crawford/PoE/README.md

# Power over Ethernet #

## Development ###

This project makes use of git commit hooks. Configure git to use them by running the following from the root of the repository:

    git config --local core.hooksPath .githooks/
