crawford/PoE/hardware/passthru/passthru.kicad_pcb

## KiCad design hardware/passthru/passthru.kicad_pcb (2023-05-25)

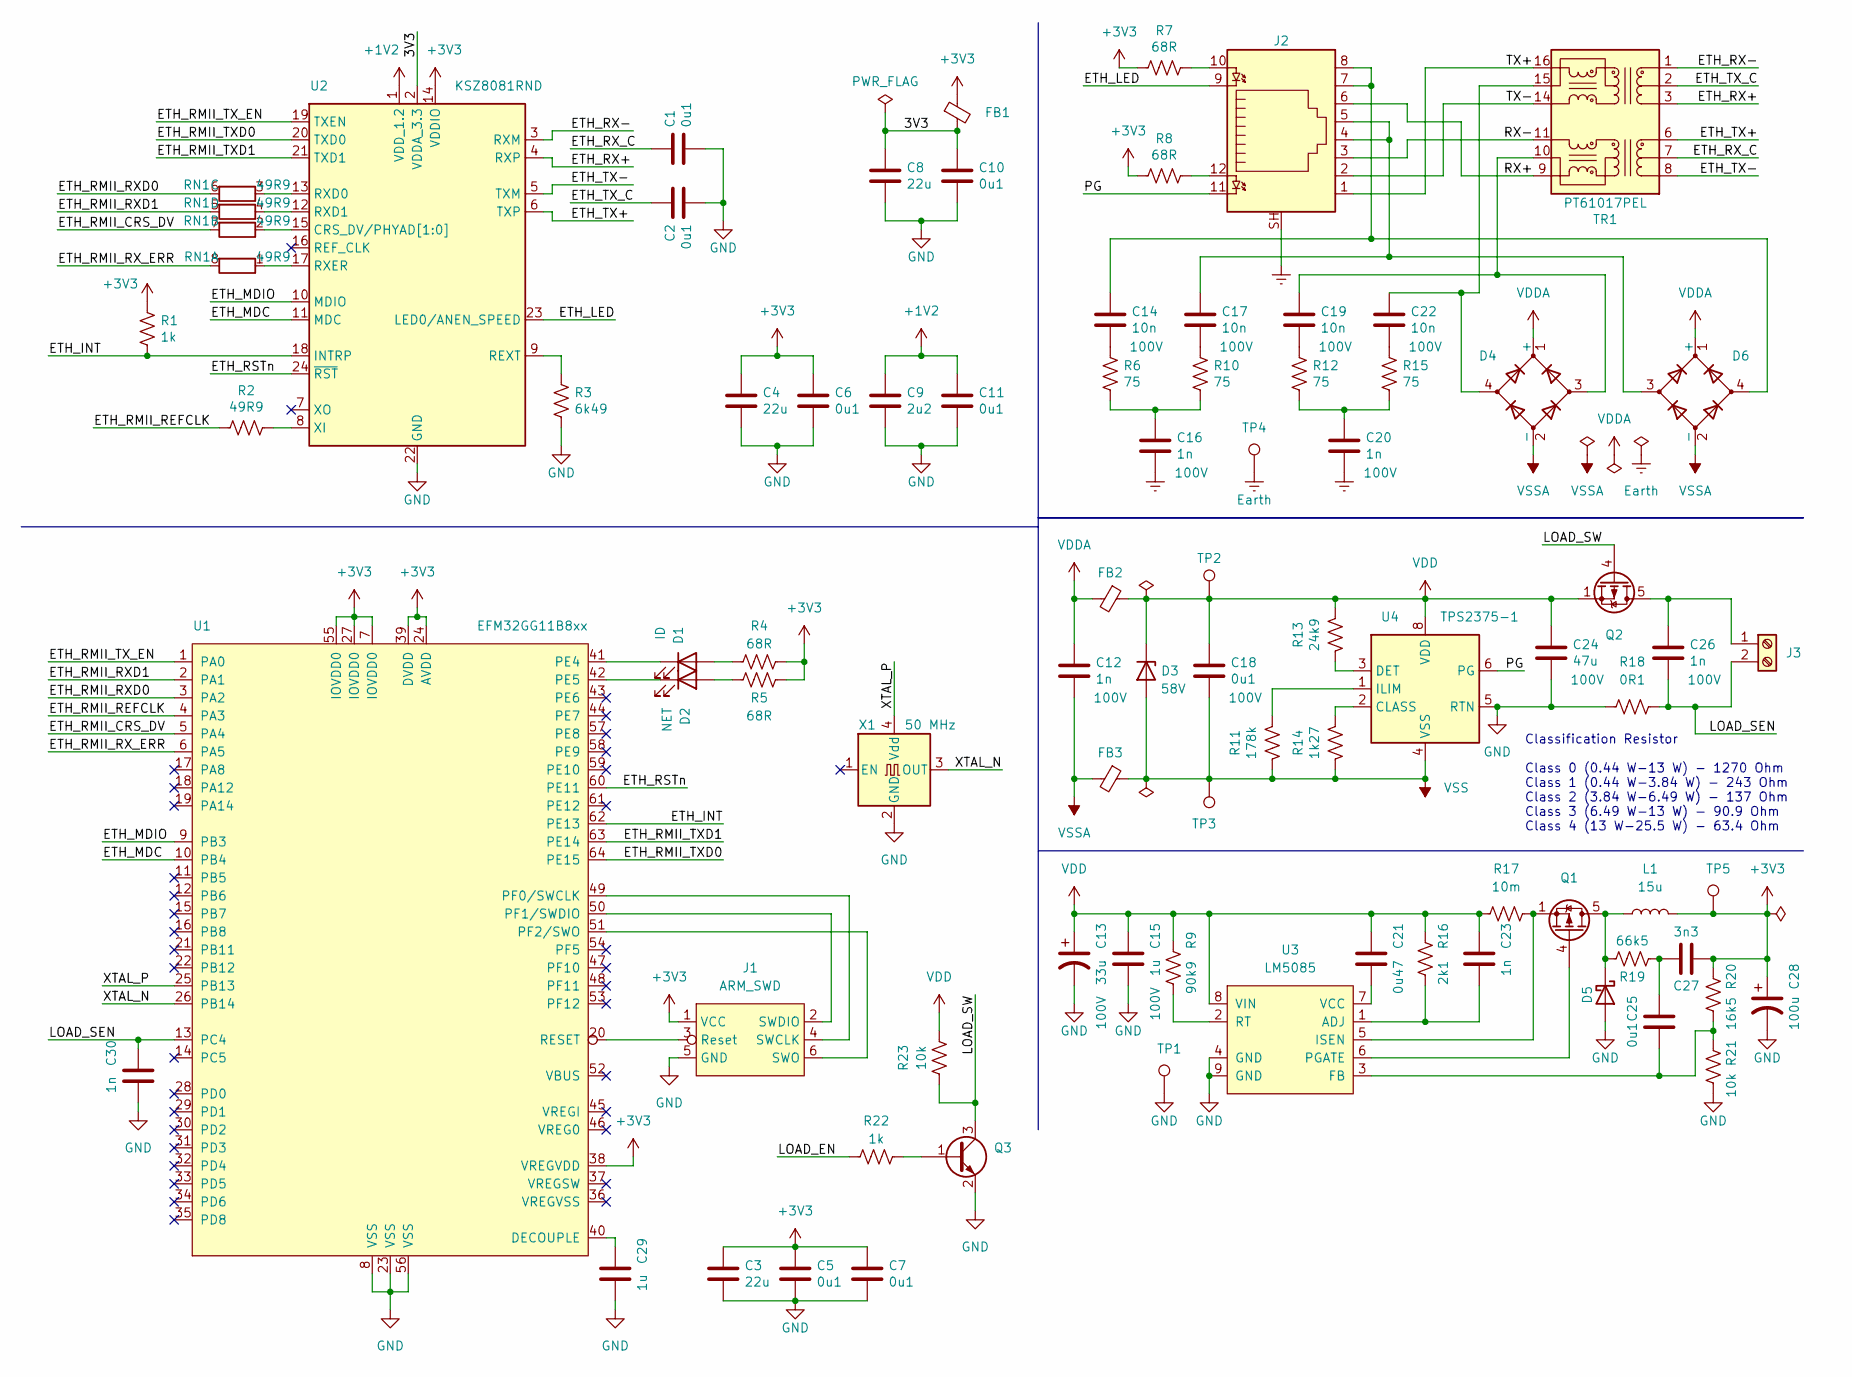
[picture p1: schematic passthru.kicad_sch, Gated Passthrough]

Parts:
C1, C2, C5, C6, C7, C10, C11, C25: 0u1; C_0603_1608Metric_Pad1.08x0.95mm_HandSolder
C3, C4, C8: 22u; C_0603_1608Metric_Pad1.08x0.95mm_HandSolder
C9: 2u2; C_0603_1608Metric_Pad1.08x0.95mm_HandSolder
C12, C16, C20, C26: 1n; C_0603_1608Metric_Pad1.08x0.95mm_HandSolder; Voltage 100V
C13: 33u; CP_Elec_10x10; Voltage 100V
C14, C17, C19, C22: 10n; C_0603_1608Metric_Pad1.08x0.95mm_HandSolder; Voltage 100V
C15: 1u; C_0603_1608Metric_Pad1.08x0.95mm_HandSolder; Voltage 100V
C18: 0u1; C_0603_1608Metric_Pad1.08x0.95mm_HandSolder; Voltage 100V
C21: 0u47; C_0603_1608Metric_Pad1.08x0.95mm_HandSolder
C23, C30: 1n; C_0603_1608Metric_Pad1.08x0.95mm_HandSolder
C24: 47u; CP_Elec_10x12.5; Voltage 100V
C27: 3n3; C_0603_1608Metric_Pad1.08x0.95mm_HandSolder
C28: 100u; CP_Elec_6.3x5.8
C29: 1u; C_0603_1608Metric_Pad1.08x0.95mm_HandSolder
D1: ID; LED_D4.0mm
D2: NET; LED_D4.0mm
D3: D_Zener; D_SMA; Voltage 58V
D4, D6: D_Bridge_+-AA; Diode_Bridge_Diotec_ABS
D5: D_Schottky; D_SOD-323F
FB1, FB2, FB3: Ferrite_Bead_Small; L_0603_1608Metric_Pad1.05x0.95mm_HandSolder
J1: ARM_SWD; Tag-Connect_TC2030-IDC-NL_2x03_P1.27mm_Vertical
J2: RJ45_LED_Shielded; RJHSE-338X
J3: Screw_Terminal_01x02; Phoenix_1935161
L1: 15u; L_1210_3225Metric_Pad1.42x2.65mm_HandSolder
Q1, Q2: Q_PMOS_DGS; PowerPAK_SO-8_Single
Q3: Q_NPN_BEC; SOT-23
R1, R22: 1k; R_0603_1608Metric_Pad0.98x0.95mm_HandSolder
R2: 49R9; R_0603_1608Metric_Pad0.98x0.95mm_HandSolder
R3: 6k49; R_0603_1608Metric_Pad0.98x0.95mm_HandSolder
R4, R5, R7, R8: 68R; R_0603_1608Metric_Pad0.98x0.95mm_HandSolder
R6, R10, R12, R15: 75; R_0603_1608Metric_Pad0.98x0.95mm_HandSolder
R9: 90k9; R_0603_1608Metric_Pad0.98x0.95mm_HandSolder
R11: 178k; R_0603_1608Metric_Pad0.98x0.95mm_HandSolder
R13: 24k9; R_0603_1608Metric_Pad0.98x0.95mm_HandSolder
R14: 1k27; R_0603_1608Metric_Pad0.98x0.95mm_HandSolder
R16: 2k1; R_0603_1608Metric_Pad0.98x0.95mm_HandSolder
R17: 10m; R_0603_1608Metric_Pad0.98x0.95mm_HandSolder
R18: 0R1; R_0805_2012Metric_Pad1.20x1.40mm_HandSolder
R19: 66k5; R_0603_1608Metric_Pad0.98x0.95mm_HandSolder
R20: 16k5; R_0603_1608Metric_Pad0.98x0.95mm_HandSolder
R21, R23: 10k; R_0603_1608Metric_Pad0.98x0.95mm_HandSolder
RN1: 49R9; R_Cat16-4
TP1: GND; TestPoint_Loop_D1.80mm_Drill1.0mm_Beaded
TP2: VDD; TestPoint_Loop_D1.80mm_Drill1.0mm_Beaded
TP3: VSS; TestPoint_Loop_D1.80mm_Drill1.0mm_Beaded
TP4: EARTH; TestPoint_Loop_D1.80mm_Drill1.0mm_Beaded
TP5: 3V3; TestPoint_Loop_D1.80mm_Drill1.0mm_Beaded
TR1: PT61017PEL
U1: EFM32GG11B8xx; QFP-64
U2: KSZ8081RND; QFN-24
U3: LM5085; WSON-8-1EP_3x3mm_P0.5mm_EP1.6x2.0mm
U4: TPS2375-1; TSSOP-8_4.4x3mm_P0.65mm
X1: 50 MHz; Oscillator_SMD_Abracon_ASE-4Pin_3.2x2.5mm

Connections:
+1V2: C9.1, C11.1, U2.1 (VDD_1.2)
+3V3: C3.1, C4.1, C5.1, C6.1, C7.1, C27.1, C28.1, FB1.1, J1.1 (VCC), L1.2, R1.1, R4.2, R5.2, R7.2, R8.2, R20.1, TP5.1, U1.7 (IOVDD0), U1.24 (AVDD), U1.27 (IOVDD0), U1.38 (VREGVDD), U1.39 (DVDD), U1.55 (IOVDD0), U2.14 (VDDIO)
/3V3: C8.1, C10.1, FB1.2, U2.2 (VDDA_3.3)
/ETH_INT: R1.2, U1.62 (PE13), U2.18 (INTRP)
/ETH_LED: J2.9, U2.23 (LED0/ANEN_SPEED)
/ETH_MDC: U1.10 (PB4), U2.11 (MDC)
/ETH_MDIO: U1.9 (PB3), U2.10 (MDIO)
/ETH_RMII_CRS_DV: RN1.7 (R2.2), U1.5 (PA4)
/ETH_RMII_REFCLK: R2.2, U1.4 (PA3)
/ETH_RMII_RXD0: RN1.6 (R3.2), U1.3 (PA2)
/ETH_RMII_RXD1: RN1.5 (R4.2), U1.2 (PA1)
/ETH_RMII_RX_ERR: RN1.8 (R1.2), U1.6 (PA5)
/ETH_RMII_TXD0: U1.64 (PE15), U2.20 (TXD0)
/ETH_RMII_TXD1: U1.63 (PE14), U2.21 (TXD1)
/ETH_RMII_TX_EN: U1.1 (PA0), U2.19 (TXEN)
/ETH_RSTn: U1.60 (PE11), U2.24 (~RST)
/ETH_RX+: TR1.3 (TD-), U2.4 (RXP)
/ETH_RX-: TR1.1 (TD+), U2.3 (RXM)
/ETH_RX_C: C1.1, TR1.7 (C_RD)
/ETH_TX+: TR1.6 (RD+), U2.6 (TXP)
/ETH_TX-: TR1.8 (RD-), U2.5 (TXM)
/ETH_TX_C: C2.1, TR1.2 (C_TD)
/LOAD_EN: R22.1
/LOAD_SEN: C26.2, C30.1, J3.2, R18.2, U1.13 (PC4)
/LOAD_SW: Q2.4 (G), Q3.3 (C), R23.1
/PG: J2.11, U4.6 (PG)
/RX+: J2.6, TR1.9 (RX-)
/RX-: J2.3, TR1.11 (RX+)
/TX+: J2.1, TR1.16 (TX+)
/TX-: J2.2, TR1.14 (TX-)
/XTAL_N: U1.26 (PB14), X1.3 (OUT)
/XTAL_P: U1.25 (PB13), X1.4 (Vdd)
Earth: C16.2, C20.2, J2.SH, TP4.1
GND: C1.2, C2.2, C3.2, C4.2, C5.2, C6.2, C7.2, C8.2, C9.2, C10.2, C11.2, C13.2, C15.2, C24.2, C28.2, C29.2, C30.2, D5.2 (A), J1.5 (GND), Q3.2 (E), R3.2, R18.1, R21.2, TP1.1, U1.8 (VSS), U1.23 (VSS), U1.56 (VSS), U2.22 (GND), U2.25 (GND), U3.4 (GND), U3.9 (GND), U4.5 (RTN), X1.2 (GND)
unnamed: C14.1, D6.4, J2.7, J2.8
unnamed: C14.2, R6.1
unnamed: C16.1, R6.2, R10.2
unnamed: C17.1, D6.3, J2.4, J2.5
unnamed: C17.2, R10.1
unnamed: C19.1, D4.3, TR1.10 (C_RX)
unnamed: C19.2, R12.1
unnamed: C20.1, R12.2, R15.2
unnamed: C21.2, U3.7 (VCC)
unnamed: C22.1, D4.4, TR1.15 (C_TX)
unnamed: C22.2, R15.1
unnamed: C23.1, R16.1, U3.1 (ADJ)
unnamed: C25.1, R20.2, R21.1, U3.3 (FB)
unnamed: C25.2, C27.2, R19.1
unnamed: C26.1, J3.1, Q2.5 (D)
unnamed: C29.1, U1.40 (DECOUPLE)
unnamed: D1.1 (K), U1.41 (PE4)
unnamed: D1.2 (A), R4.1
unnamed: D2.1 (K), U1.42 (PE5)
unnamed: D2.2 (A), R5.1
unnamed: D5.1 (K), L1.1, Q1.5 (D), R19.2
unnamed: J1.2 (SWDIO), U1.50 (PF1/SWDIO)
unnamed: J1.3 (Reset), U1.20 (RESET)
unnamed: J1.4 (SWCLK), U1.49 (PF0/SWCLK)
unnamed: J1.6 (SWO), U1.51 (PF2/SWO)
unnamed: J2.10, R7.1
unnamed: J2.12, R8.1
unnamed: Q1.1 (S), Q1.2 (S), Q1.3 (S), R17.2, U3.5 (ISEN)
unnamed: Q1.4 (G), U3.6 (PGATE)
unnamed: Q3.1 (B), R22.2
unnamed: R2.1, U2.8 (XI)
unnamed: R3.1, U2.9 (REXT)
unnamed: R9.1, U3.2 (RT)
unnamed: R11.2, U4.1 (ILIM)
unnamed: R13.1, U4.3 (DET)
unnamed: R14.2, U4.2 (CLASS)
unnamed: RN1.1 (R1.1), U2.17 (RXER)
unnamed: RN1.2 (R2.1), U2.15 (CRS_DV/PHYAD[1:0])
unnamed: RN1.3 (R3.1), U2.13 (RXD0)
unnamed: RN1.4 (R4.1), U2.12 (RXD1)
VDD: C13.1, C15.1, C18.1, C21.1, C23.2, C24.1, D3.1 (K), FB2.1, Q2.1 (S), Q2.2 (S), Q2.3 (S), R9.2, R13.2, R16.2, R17.1, R23.2, TP2.1, U3.8 (VIN), U4.8 (VDD)
VDDA: C12.1, D4.1 (+), D6.1 (+), FB2.2
VSS: C18.2, D3.2 (A), FB3.1, R11.1, R14.1, TP3.1, U4.4 (VSS)
VSSA: C12.2, D4.2 (-), D6.2 (-), FB3.2

Notes on the sheet:
Classification Resistor Class 0 (0.44 W-13 W) - 1270 Ohm Class 1 (0.44 W-3.84 W) - 243 Ohm Class 2 (3.84 W-6.49 W) - 137 Ohm Class 3 (6.49 W-13 W) - 90.9 Ohm Class 4 (13 W-25.5 W) - 63.4 Ohm

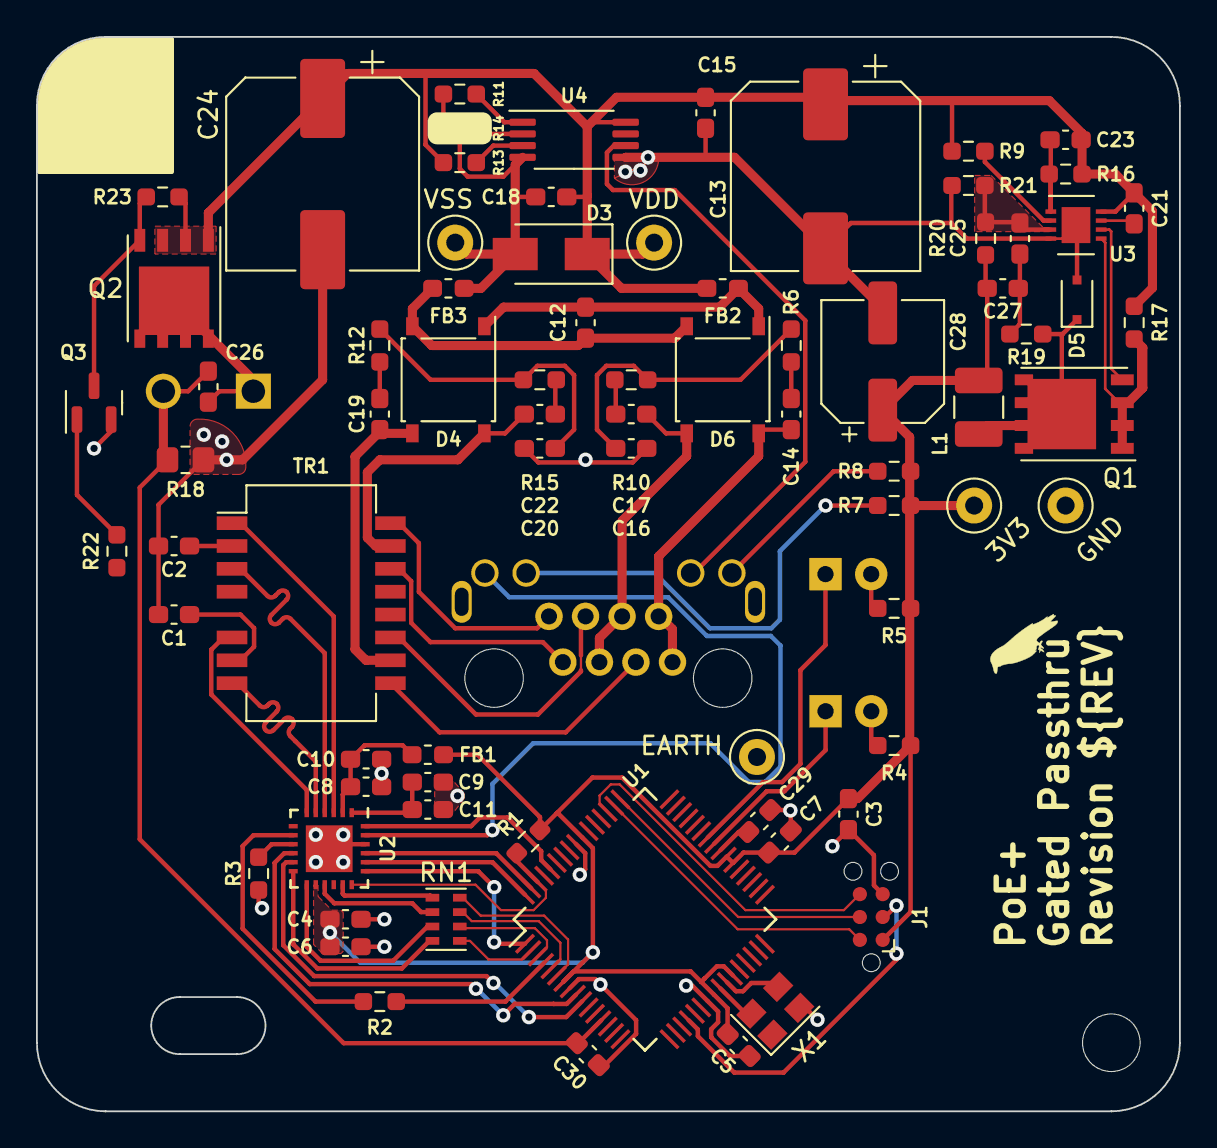
[picture p2: board passthru.kicad_pcb from above]

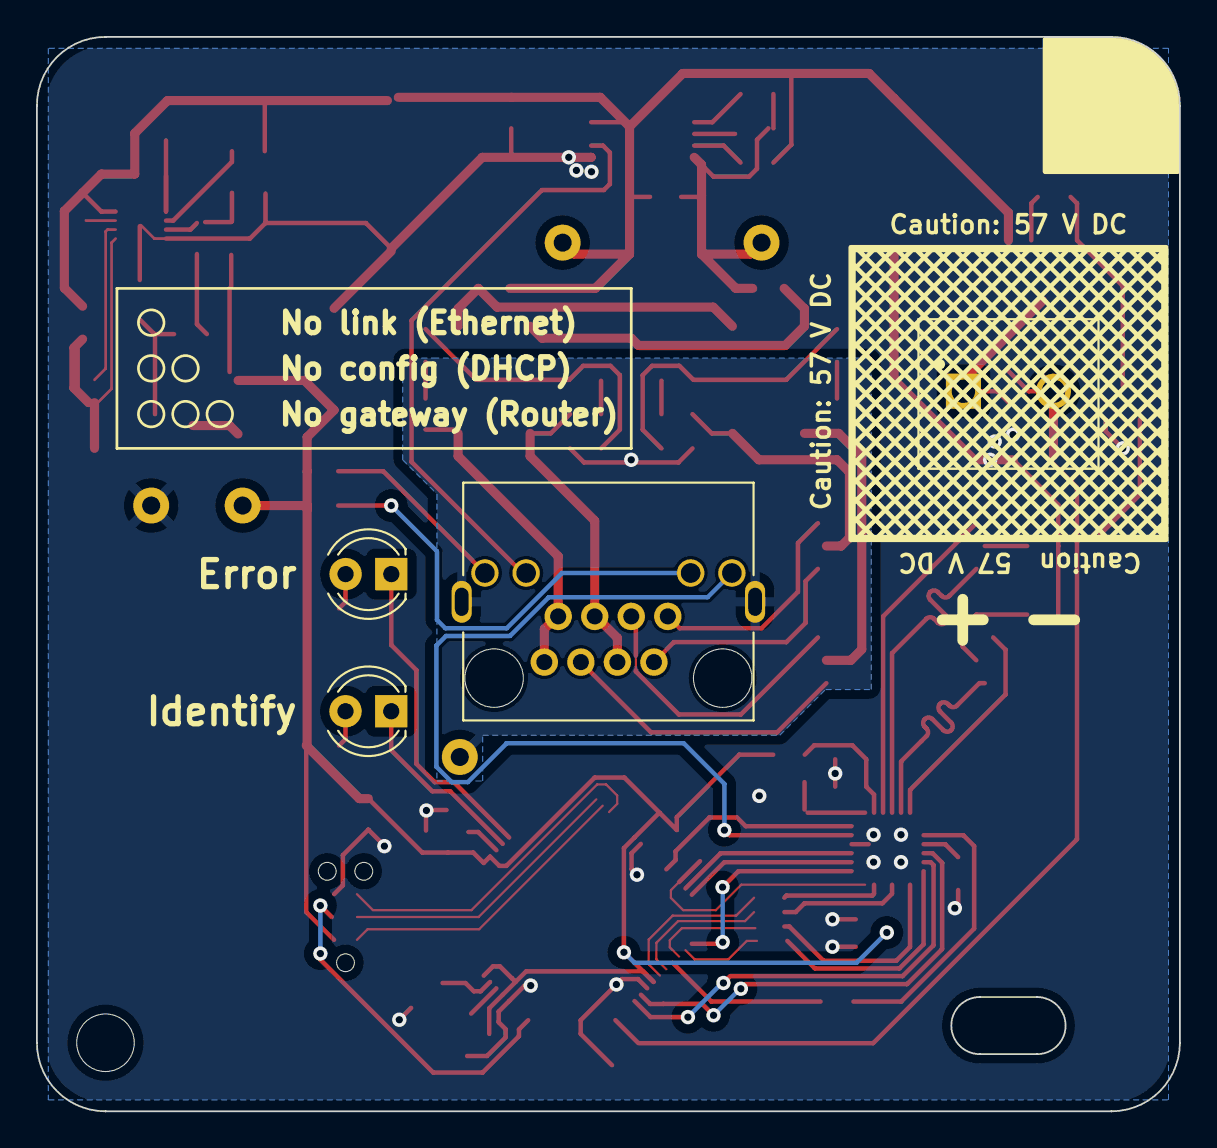
[picture p3: board passthru.kicad_pcb from below]

Board: 2 copper layers, 63.5 x 59.7 mm, 81 parts (4 on the bottom side), 77 nets.
