crawford/PoE/hardware/sync-flyback-eval/sync-flyback-eval.kicad_pcb

## KiCad design hardware/sync-flyback-eval/sync-flyback-eval.kicad_pcb (2022-09-16)

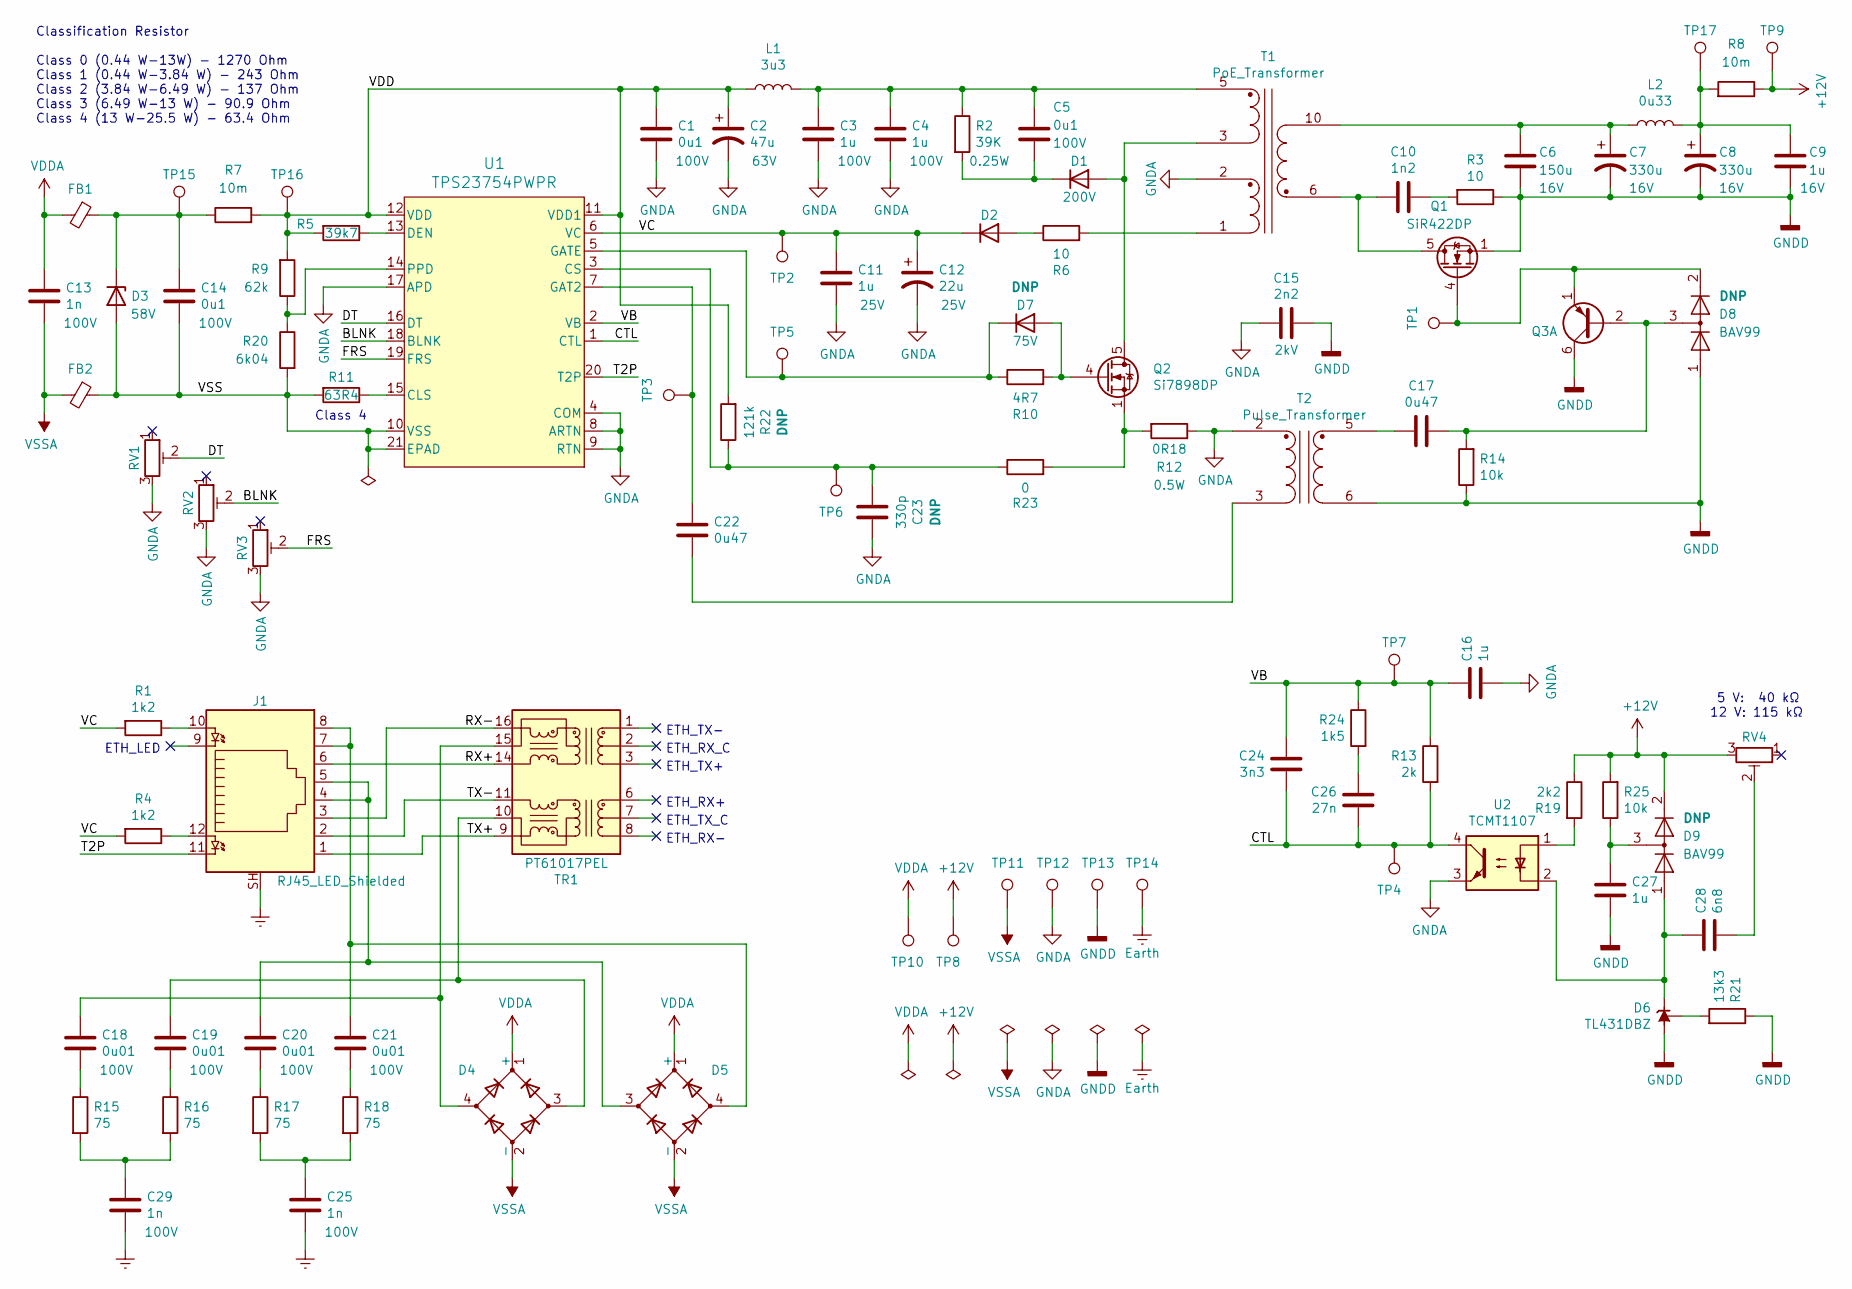
[picture p4: schematic sync-flyback-eval.kicad_sch, Synchronous Flyback Converter - Evaluation Board]

Parts:
C1, C5, C14: 0u1; C_0402_1005Metric; Voltage 100V
C2: 47u; C_Elec_8x10.2; Voltage 63V
C3, C4: 1u; C_0805_2012Metric; Voltage 100V
C6: 150u; C_Elec_6.3x7.7; Voltage 16V
C7, C8: 330u; C_Elec_8x10.2; Voltage 16V
C9: 1u; C_0402_1005Metric; Voltage 16V
C10: 1n2; C_0402_1005Metric
C11: 1u; C_0402_1005Metric; Voltage 25V
C12: 22u; C_Elec_5x5.4; Voltage 25V
C13, C25, C29: 1n; C_0402_1005Metric; Voltage 100V
C15: 2n2; C_Disc_D10.0mm_W2.5mm_P5.00mm; Voltage 2kV
C16, C27: 1u; C_0402_1005Metric
C17, C22: 0u47; C_0402_1005Metric
C18, C19, C20, C21: 0u01; C_0402_1005Metric; Voltage 100V
C23: 330p; C_0402_1005Metric
C24: 3n3; C_0402_1005Metric
C26: 27n; C_0402_1005Metric
C28: 6n8; C_0402_1005Metric
D1: D; D_SMB; Voltage 200V
D2: D; D_SOD-323
D3: D_Zener; D_SMA; Voltage 58V
D4, D5: D_Bridge_+-AA; Diode_Bridge_Diotec_ABS
D6: TL431DBZ; SOT-23
D7: D; D_SOD-323; Voltage 75V
D8, D9: BAV99; SOT-23
FB1, FB2: Ferrite_Bead_Small; R_1206_3216Metric
J1: RJ45_LED_Shielded; RJHSE-538X
L1: 3u3; L_Abracon_ASPI-0630LR
L2: 0u33; L_Abracon_ASPI-0630LR
Q1: SiR422DP; PowerPAK_SO-8_Single
Q2: Si7898DP; PowerPAK_SO-8_Single
Q3: MMDT3906; SOT-363_SC-70-6
R1, R4: 1k2; R_0402_1005Metric
R2: 39K; R_0805_2012Metric
R3, R6: 10; R_0805_2012Metric
R5: 39k7; R_0402_1005Metric
R7, R8: 10m; R_0402_1005Metric
R9: 62k; R_0402_1005Metric
R10: 4R7; R_0402_1005Metric
R11: 63R4; R_0402_1005Metric
R12: 0R18; R_0805_2012Metric
R13: 2k; R_0402_1005Metric
R14, R25: 10k; R_0402_1005Metric
R15, R16, R17, R18: 75; R_0402_1005Metric
R19: 2k2; R_0402_1005Metric
R20: 6k04; R_0402_1005Metric
R21: 13k3; R_0402_1005Metric
R22: 121k; R_0402_1005Metric
R23: 0; R_0402_1005Metric
R24: 1k5; R_0402_1005Metric
RV1, RV2, RV3, RV4: 0-200k; TRIM_3306F-1-204
T1: PoE_Transformer; WE-PoE+
T2: Pulse_Transformer; WE-GDTI
TP1: TestPoint; TestPoint_Pad_1.5x1.5mm
TP2: VC; TestPoint_Loop_D1.80mm_Drill1.0mm_Beaded
TP3: GAT2; TestPoint_Pad_1.5x1.5mm
TP4: CTL; TestPoint_Pad_1.5x1.5mm
TP5: GAT; TestPoint_Pad_1.5x1.5mm
TP6: CS; TestPoint_Pad_1.5x1.5mm
TP7, TP9, TP15, TP16, TP17: VB; TestPoint_Loop_D1.80mm_Drill1.0mm_Beaded
TP8: 12V; TestPoint_Loop_D1.80mm_Drill1.0mm_Beaded
TP10: VDDA1; TestPoint_Loop_D1.80mm_Drill1.0mm_Beaded
TP11: VSSA1; TestPoint_Loop_D1.80mm_Drill1.0mm_Beaded
TP12, TP13: GND; TestPoint_Loop_D1.80mm_Drill1.0mm_Beaded
TP14: EARTH; TestPoint_Loop_D1.80mm_Drill1.0mm_Beaded
TR1: PT61017PEL
U1: TPS23754PWPR; TSSOP-20
U2: TCMT1107; SOP-4_4.4x2.6mm_P1.27mm

Connections:
+12V: D9.2 (A), R8.1, R19.1, R25.2, RV4.3, TP8.1, TP9.1
/BLNK: RV2.2, U1.18 (BLNK)
/CTL: C24.2, C26.2, R13.2, TP4.1, U1.1 (CTL), U2.4
/DT: RV1.2, U1.16 (DT)
/FRS: RV3.2, U1.19 (FRS)
/RX+: J1.6, TR1.14 (TX-)
/RX-: J1.3, TR1.16 (TX+)
/T2P: J1.11, U1.20 (T2P)
/TX+: J1.1, TR1.9 (RX-)
/TX-: J1.2, TR1.11 (RX+)
/VB: C16.1, C24.1, R13.1, R24.1, TP7.1, U1.2 (VB)
/VC: C11.1, C12.1, D2.1 (K), R1.2, R4.2, TP2.1, U1.6 (VC)
/VDD: C1.1, C2.1, L1.1, R5.2, R7.2, R9.2, R22.2, TP16.1, U1.11 (VDD1), U1.12 (VDD)
/VSS: C14.2, D3.2 (A), FB2.1, R11.2, R20.2, U1.10 (VSS), U1.21 (EPAD)
Earth: C25.2, C29.2, J1.SH, TP14.1
GNDA: C1.2, C2.2, C3.2, C4.2, C11.2, C12.2, C15.2, C16.2, C23.1, R12.1, RV1.3, RV2.3, RV3.3, T1.2 (SC), T2.2 (AA), TP12.1, U1.4 (COM), U1.8 (ARTN), U1.9 (RTN), U1.17 (APD), U2.3
GNDD: C6.2, C7.2, C8.2, C9.2, C15.1, C27.2, D6.3 (A), D8.1 (K), Q1.1 (S), Q1.2 (S), Q1.3 (S), Q3.6 (C1), R3.1, R14.1, R21.1, T2.6 (SA), TP13.1
unnamed: C3.1, C4.1, C5.1, L1.2, R2.1, T1.5 (SA)
unnamed: C5.2, D1.1 (K), R2.2
unnamed: C6.1, C7.1, L2.1, T1.10 (AA)
unnamed: C8.1, C9.1, L2.2, R8.2, TP17.1
unnamed: C10.1, R3.2
unnamed: C10.2, Q1.5 (D), T1.6 (AB)
unnamed: C14.1, D3.1 (K), FB1.1, R7.1, TP15.1
unnamed: C17.1, D8.3 (K), Q3.2 (B1), R14.2
unnamed: C17.2, T2.5 (SB)
unnamed: C18.1, D4.4, TR1.15 (C_TX)
unnamed: C18.2, R15.1
unnamed: C19.1, D4.3, TR1.10 (C_RX)
unnamed: C19.2, R16.1
unnamed: C20.1, D5.3, J1.4, J1.5
unnamed: C20.2, R17.1
unnamed: C21.1, D5.4, J1.7, J1.8
unnamed: C21.2, R18.1
unnamed: C22.1, T2.3 (AB)
unnamed: C22.2, TP3.1, U1.7 (GAT2)
unnamed: C23.2, R22.1, R23.1, TP6.1, U1.3 (CS)
unnamed: C25.1, R17.2, R18.2
unnamed: C26.1, R24.2
unnamed: C27.1, D9.3 (K), R25.1
unnamed: C28.1, D6.1 (K), D9.1 (K), U2.2
unnamed: C28.2, RV4.2
unnamed: C29.1, R15.2, R16.2
unnamed: D1.2 (A), Q2.5 (D), T1.3 (SB)
unnamed: D2.2 (A), R6.1
unnamed: D6.2 (REF), R21.2
unnamed: D7.1 (K), R10.1, TP5.1, U1.5 (GATE)
unnamed: D7.2 (A), Q2.4 (G), R10.2
unnamed: D8.2 (A), Q1.4 (G), Q3.1 (E1), TP1.1
unnamed: J1.10, R1.1
unnamed: J1.12, R4.1
unnamed: Q2.1 (S), Q2.2 (S), Q2.3 (S), R12.2, R23.2
unnamed: R5.1, U1.13 (DEN)
unnamed: R6.2, T1.1 (SD)
unnamed: R11.1, U1.15 (CLS)
unnamed: R19.2, U2.1
unnamed: R9.1, R20.1, U1.14 (PPD)
VDDA: C13.1, D4.1 (+), D5.1 (+), FB1.2, TP10.1
VSSA: C13.2, D4.2 (-), D5.2 (-), FB2.2, TP11.1

Notes on the sheet:
5 V: 40 kΩ 12 V: 115 kΩ
ETH_RX_C
ETH_LED
ETH_TX-
ETH_TX+
Classification Resistor Class 0 (0.44 W-13W) - 1270 Ohm Class 1 (0.44 W-3.84 W) - 243 Ohm Class 2 (3.84 W-6.49 W) - 137 Ohm Class 3 (6.49 W-13 W) - 90.9 Ohm Class 4 (13 W-25.5 W) - 63.4 Ohm
ETH_RX-
ETH_RX+
ETH_TX_C
Class 4

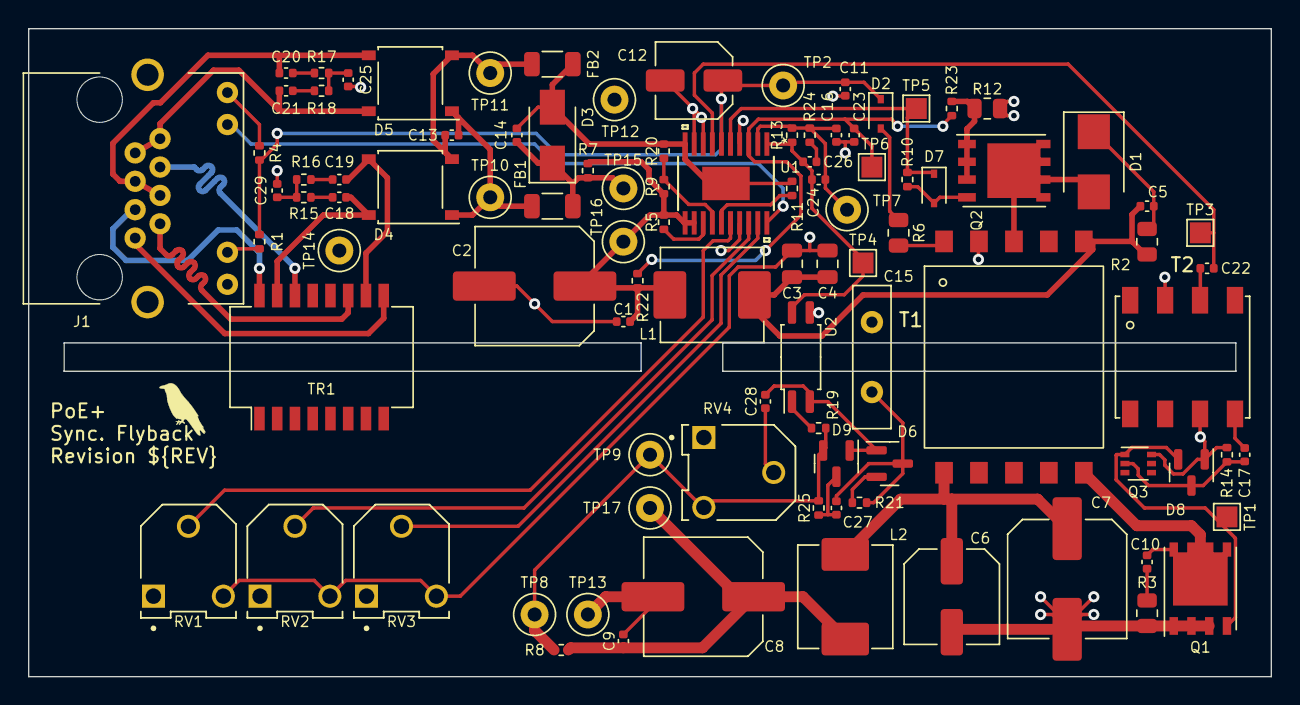
[picture p5: board sync-flyback-eval.kicad_pcb from above]

Board: 2 copper layers, 88.9 x 46.4 mm, 97 parts (0 on the bottom side), 59 nets.
