crawford/PoE/hardware/chassis/chassis.kicad_pcb

## KiCad design hardware/chassis/chassis.kicad_pcb (2022-07-24)

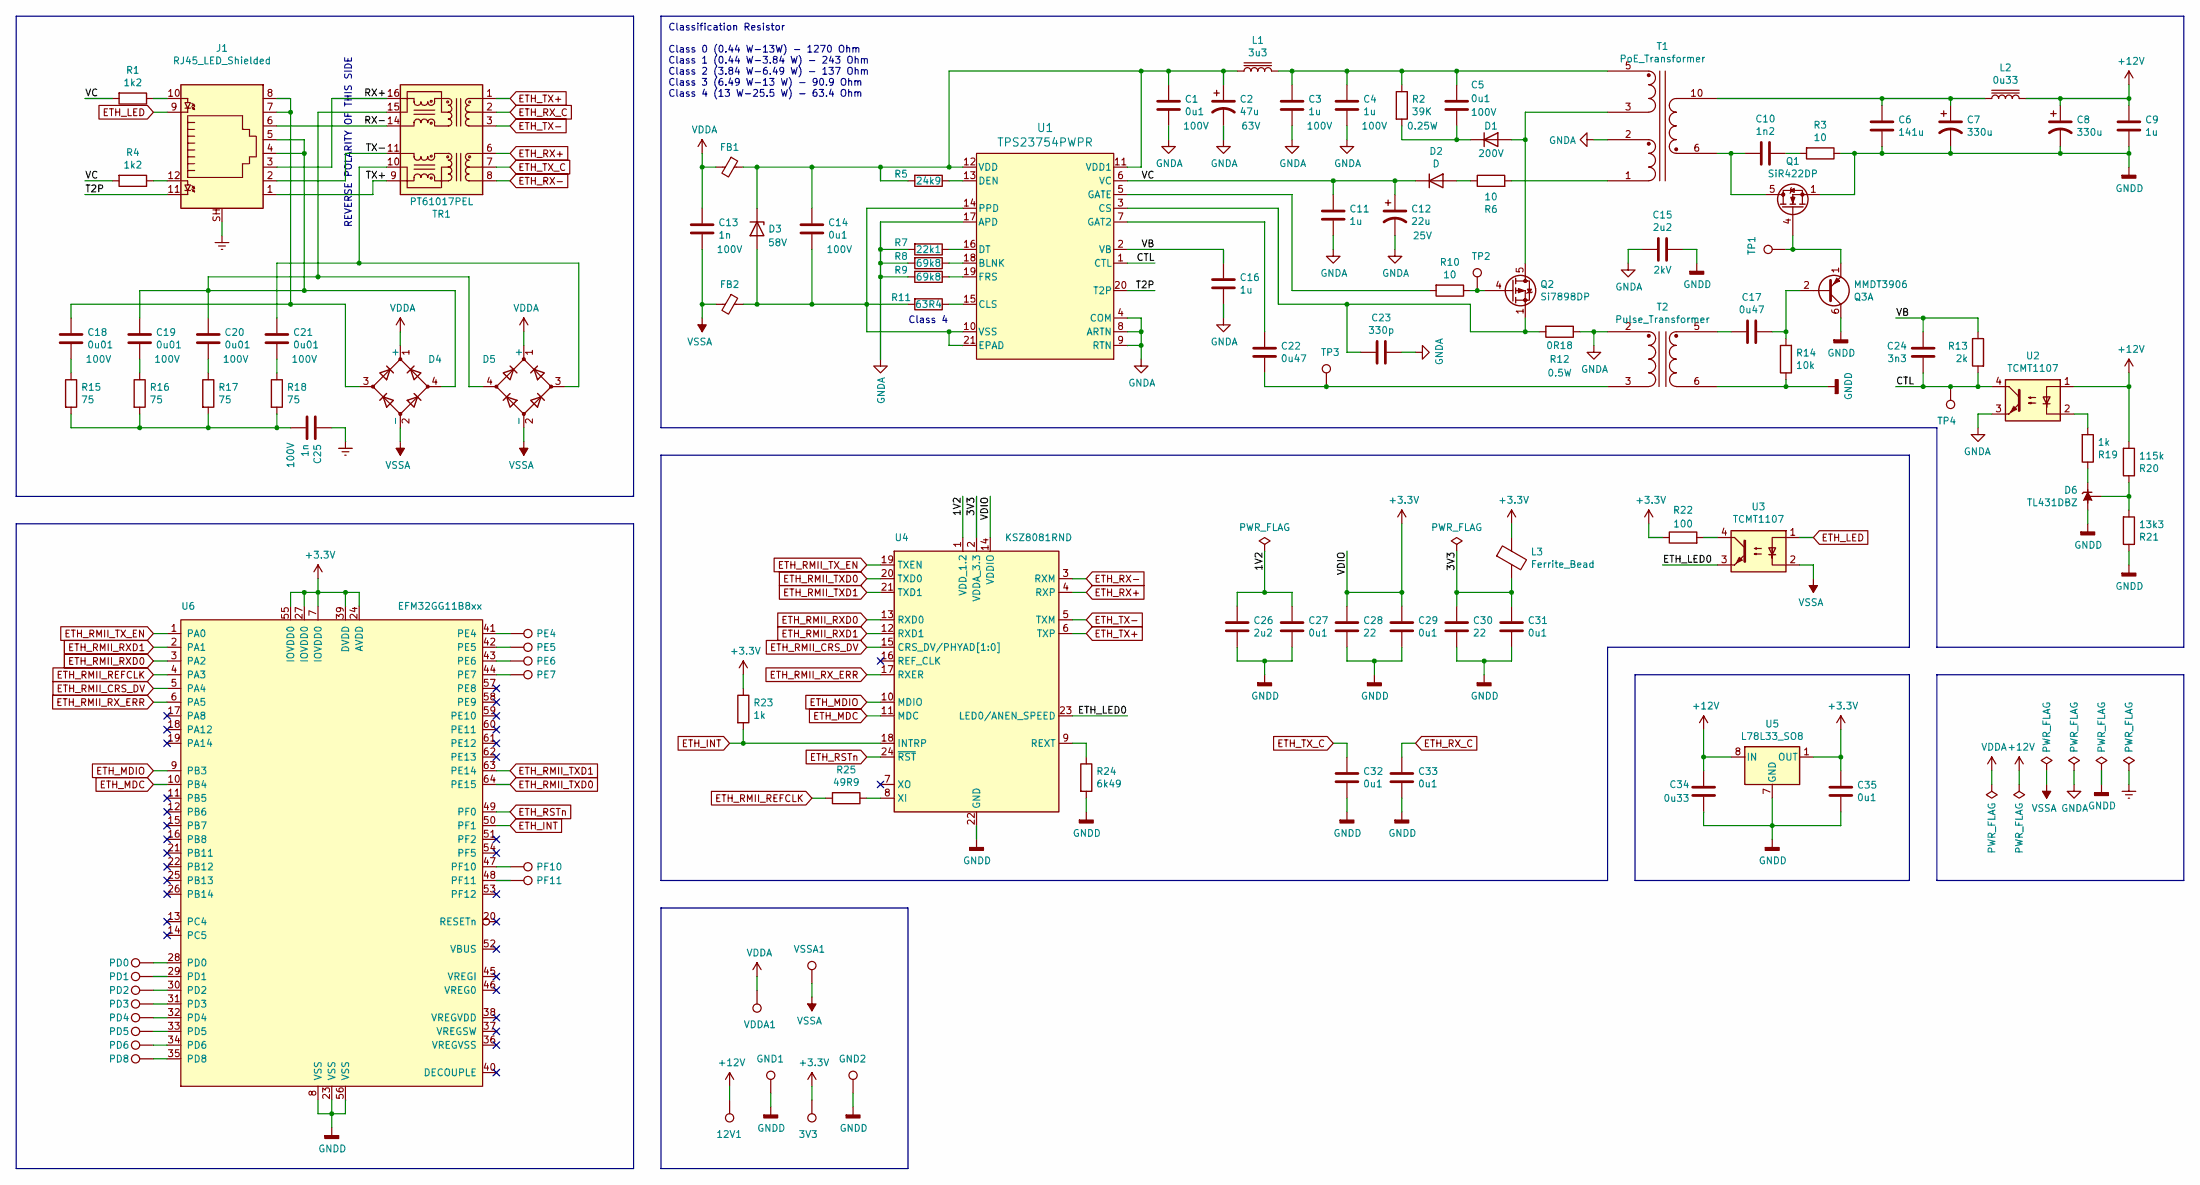
[picture p6: schematic chassis.kicad_sch, Power Over Ethernet Chassis]

Parts:
3V3: TestPoint; TestPoint_Pad_1.5x1.5mm
12V1: TestPoint; TestPoint_Loop_D1.80mm_Drill1.0mm_Beaded
C1, C5, C14: 0u1; C_0402_1005Metric; Voltage 100V
C2: 47u; C_0402_1005Metric; Voltage 63V
C3, C4: 1u; C_0402_1005Metric; Voltage 100V
C6: 141u; C_0402_1005Metric
C7, C8: 330u; C_0402_1005Metric
C9, C11, C16: 1u; C_0402_1005Metric
C10: 1n2; C_0402_1005Metric
C12: 22u; C_0402_1005Metric; Voltage 25V
C13, C25: 1n; C_0402_1005Metric; Voltage 100V
C15: 2u2; C_0402_1005Metric; Voltage 2kV
C17, C22: 0u47; C_0402_1005Metric
C18, C19, C20, C21: 0u01; C_0402_1005Metric; Voltage 100V
C23: 330p; C_0402_1005Metric
C24: 3n3; C_0402_1005Metric
C26: 2u2; C_0402_1005Metric
C27, C29, C31, C32, C33, C35: 0u1; C_0402_1005Metric
C28, C30: 22; C_0402_1005Metric
C34: 0u33; C_0402_1005Metric
D1: D; D_0402_1005Metric; Voltage 200V
D2: D; D_0402_1005Metric
D3: D_Zener; D_0402_1005Metric; Voltage 58V
D4, D5: D_Bridge_+-AA; Diode_Bridge_Diotec_ABS
D6: TL431DBZ; SOT-23
FB1, FB2: Ferrite_Bead_Small; R_1206_3216Metric
GND1: TestPoint; TestPoint_Loop_D1.80mm_Drill1.0mm_Beaded
GND2: TestPoint; TestPoint_Pad_1.5x1.5mm
J1: RJ45_LED_Shielded; RJHSE-538X
L1: 3u3; L_0402_1005Metric
L2: 0u33; L_0402_1005Metric
L3: Ferrite_Bead; L_0402_1005Metric
PD0, PD1, PD2, PD3, PD4, PD5, PD6, PD8: TestPoint; TestPoint_Pad_1.5x1.5mm
PE4, PE5, PE6, PE7: TestPoint; TestPoint_Pad_1.5x1.5mm
PF10, PF11: TestPoint; TestPoint_Pad_1.5x1.5mm
Q1: SiR422DP; PowerPAK_SO-8_Single
Q2: Si7898DP; PowerPAK_SO-8_Single
Q3: MMDT3906; SOT-363_SC-70-6
R1, R4: 1k2; R_0402_1005Metric
R2: 39K; R_0402_1005Metric
R3, R6, R10: 10; R_0402_1005Metric
R5: 24k9; R_0402_1005Metric
R7: 22k1; R_0402_1005Metric
R8, R9: 69k8; R_0402_1005Metric
R11: 63R4; R_0402_1005Metric
R12: 0R18; R_0402_1005Metric
R13: 2k; R_0402_1005Metric
R14: 10k; R_0402_1005Metric
R15, R16, R17, R18: 75; R_0402_1005Metric
R19, R23: 1k; R_0402_1005Metric
R20: 115k; R_0402_1005Metric
R21: 13k3; R_0402_1005Metric
R22: 100; R_0402_1005Metric
R24: 6k49; R_0402_1005Metric
R25: 49R9; R_0402_1005Metric
T1: PoE_Transformer; POE_EP13
T2: Pulse_Transformer; GDTI_EP7
TP1, TP2, TP3, TP4: TestPoint; TestPoint_Pad_1.5x1.5mm
TR1: PT61017PEL; Transformer_Ethernet_Bourns_PT61017PEL
U1: TPS23754PWPR; TSSOP-20
U2, U3: TCMT1107; SOP-4_4.4x2.6mm_P1.27mm
U4: KSZ8081RND; QFN-24
U5: L78L33_SO8; SOIC-8_3.9x4.9mm_P1.27mm
U6: EFM32GG11B8xx; QFP-64
VDDA1: TestPoint; TestPoint_Pad_1.5x1.5mm
VSSA1: TestPoint; TestPoint_Pad_1.5x1.5mm

Connections:
+3V3: 3V3.1, C28.1, C29.1, C35.1, L3.1, R22.1, R23.1, U4.14 (VDDIO), U5.1 (OUT), U6.7 (IOVDD0), U6.24 (AVDD), U6.27 (IOVDD0), U6.39 (DVDD), U6.55 (IOVDD0)
+12V: 12V1.1, C8.1, C9.1, C34.1, L2.2, R20.2, U2.1, U5.8 (IN)
/1V2: C26.1, C27.1, U4.1 (VDD_1.2)
/3V3: C30.1, C31.1, L3.2, U4.2 (VDDA_3.3)
/CTL: C24.2, R13.2, TP4.1, U1.1 (CTL), U2.4
/ETH_LED0: U3.3, U4.23 (LED0/ANEN_SPEED)
/RX+: J1.3, TR1.16 (TX+)
/RX-: J1.6, TR1.14 (TX-)
/T2P: J1.11, U1.20 (T2P)
/TX+: J1.1, TR1.9 (RX-)
/TX-: J1.2, TR1.11 (RX+)
/VB: C16.1, C24.1, R13.1, U1.2 (VB)
/VC: C11.1, C12.1, D2.1 (K), R1.2, R4.2, U1.6 (VC)
ETH_INT: R23.2, U4.18 (INTRP), U6.50 (PF1)
ETH_LED: J1.9, U3.1
ETH_MDC: U4.11 (MDC), U6.10 (PB4)
ETH_MDIO: U4.10 (MDIO), U6.9 (PB3)
ETH_RMII_CRS_DV: U4.15 (CRS_DV/PHYAD[1:0]), U6.5 (PA4)
ETH_RMII_REFCLK: R25.2, U6.4 (PA3)
ETH_RMII_RXD0: U4.13 (RXD0), U6.3 (PA2)
ETH_RMII_RXD1: U4.12 (RXD1), U6.2 (PA1)
ETH_RMII_RX_ERR: U4.17 (RXER), U6.6 (PA5)
ETH_RMII_TXD0: U4.20 (TXD0), U6.64 (PE15)
ETH_RMII_TXD1: U4.21 (TXD1), U6.63 (PE14)
ETH_RMII_TX_EN: U4.19 (TXEN), U6.1 (PA0)
ETH_RSTn: U4.24 (~RST), U6.49 (PF0)
ETH_RX+: TR1.6 (RD+), U4.4 (RXP)
ETH_RX-: TR1.8 (RD-), U4.3 (RXM)
ETH_RX_C: C33.1, TR1.2 (C_TD)
ETH_TX+: TR1.1 (TD+), U4.6 (TXP)
ETH_TX-: TR1.3 (TD-), U4.5 (TXM)
ETH_TX_C: C32.1, TR1.7 (C_RD)
Earth: C25.1, J1.SH
GNDA: C1.2, C2.2, C3.2, C4.2, C11.2, C12.2, C15.2, C16.2, C23.1, R7.2, R8.2, R9.2, R12.1, T1.2 (SC), T2.2 (AA), U1.4 (COM), U1.8 (ARTN), U1.9 (RTN), U1.17 (APD), U2.3
GNDD: C6.2, C7.2, C8.2, C9.2, C15.1, C26.2, C27.2, C28.2, C29.2, C30.2, C31.2, C32.2, C33.2, C34.2, C35.2, D6.3 (A), GND1.1, GND2.1, Q1.1 (S), Q1.2 (S), Q1.3 (S), Q3.6 (C1), R3.1, R14.1, R21.1, R24.2, T2.6 (SA), U4.22 (GND), U4.25 (GND), U5.2 (GND), U5.3 (GND), U5.6 (GND), U5.7 (GND), U6.8 (VSS), U6.23 (VSS), U6.56 (VSS)
unnamed: C1.1, C2.1, C14.1, D3.1 (K), FB1.1, L1.1, R5.2, U1.11 (VDD1), U1.12 (VDD)
unnamed: C3.1, C4.1, C5.1, L1.2, R2.1, T1.5 (SA)
unnamed: C5.2, D1.1 (K), R2.2
unnamed: C6.1, C7.1, L2.1, T1.10 (AA)
unnamed: C10.1, R3.2
unnamed: C10.2, Q1.5 (D), T1.6 (AB)
unnamed: C14.2, D3.2 (A), FB2.1, R11.2, U1.10 (VSS), U1.14 (PPD), U1.21 (EPAD)
unnamed: C17.1, Q3.2 (B1), R14.2
unnamed: C17.2, T2.5 (SB)
unnamed: C18.1, D4.3, J1.7, J1.8
unnamed: C18.2, R15.1
unnamed: C19.1, C20.1, D4.4, D5.4, J1.4, J1.5, TR1.15 (C_TX)
unnamed: C19.2, R16.1
unnamed: C20.2, R17.1
unnamed: C21.1, D5.3, TR1.10 (C_RX)
unnamed: C21.2, R18.1
unnamed: C22.1, T2.3 (AB), TP3.1
unnamed: C22.2, U1.7 (GAT2)
unnamed: C23.2, Q2.1 (S), Q2.2 (S), Q2.3 (S), R12.2, U1.3 (CS)
unnamed: C25.2, R15.2, R16.2, R17.2, R18.2
unnamed: D1.2 (A), Q2.5 (D), T1.3 (SB)
unnamed: D2.2 (A), R6.1
unnamed: D6.1 (K), R19.1
unnamed: D6.2 (REF), R20.1, R21.2
unnamed: J1.10, R1.1
unnamed: J1.12, R4.1
unnamed: PD0.1, U6.28 (PD0)
unnamed: PD1.1, U6.29 (PD1)
unnamed: PD2.1, U6.30 (PD2)
unnamed: PD3.1, U6.31 (PD3)
unnamed: PD4.1, U6.32 (PD4)
unnamed: PD5.1, U6.33 (PD5)
unnamed: PD6.1, U6.34 (PD6)
unnamed: PD8.1, U6.35 (PD8)
unnamed: PE4.1, U6.41 (PE4)
unnamed: PE5.1, U6.42 (PE5)
unnamed: PE6.1, U6.43 (PE6)
unnamed: PE7.1, U6.44 (PE7)
unnamed: PF10.1, U6.47 (PF10)
unnamed: PF11.1, U6.48 (PF11)
unnamed: Q1.4 (G), Q3.1 (E1), TP1.1
unnamed: Q2.4 (G), R10.1, TP2.1
unnamed: R5.1, U1.13 (DEN)
unnamed: R6.2, T1.1 (SD)
unnamed: R7.1, U1.16 (DT)
unnamed: R8.1, U1.18 (BLNK)
unnamed: R9.1, U1.19 (FRS)
unnamed: R10.2, U1.5 (GATE)
unnamed: R11.1, U1.15 (CLS)
unnamed: R19.2, U2.2
unnamed: R22.2, U3.4
unnamed: R24.1, U4.9 (REXT)
unnamed: R25.1, U4.8 (XI)
VDDA: C13.1, D4.1 (+), D5.1 (+), FB1.2, VDDA1.1
VSSA: C13.2, D4.2 (-), D5.2 (-), FB2.2, U3.2, VSSA1.1

Notes on the sheet:
REVERSE POLARITY OF THIS SIDE
Classification Resistor Class 0 (0.44 W-13W) - 1270 Ohm Class 1 (0.44 W-3.84 W) - 243 Ohm Class 2 (3.84 W-6.49 W) - 137 Ohm Class 3 (6.49 W-13 W) - 90.9 Ohm Class 4 (13 W-25.5 W) - 63.4 Ohm
Class 4
