crawford/PoE/hardware/chassis/chassis.kicad_pcb

## KiCad design hardware/chassis/chassis.kicad_pcb (continued)

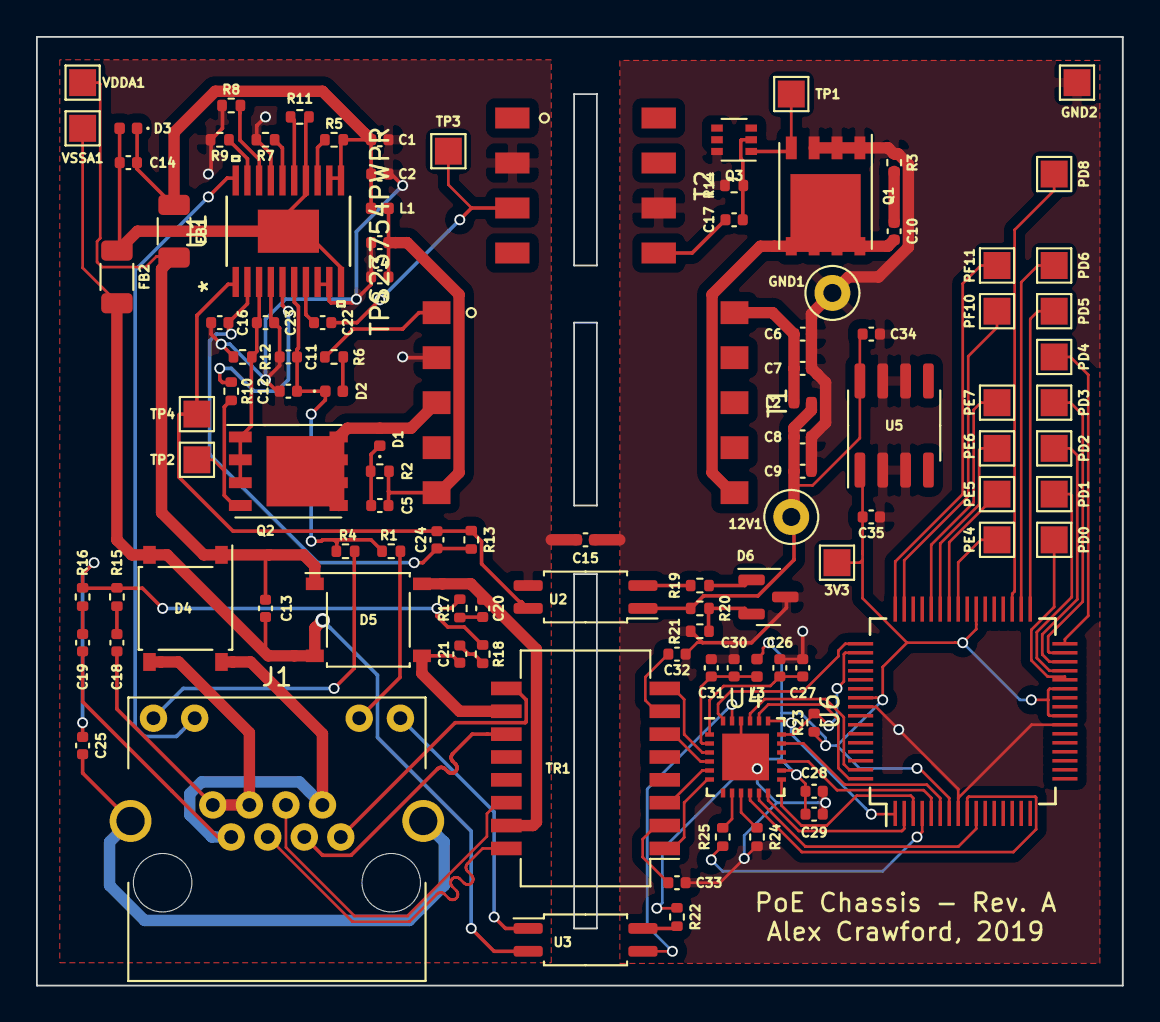
[picture p7: board chassis.kicad_pcb from above]

Board: 2 copper layers, 60.3 x 52.7 mm, 108 parts (0 on the bottom side), 90 nets.
