crawford/PoE/firmware/src/api.rs

// Copyright 2025 Alex Crawford
//
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
use core::cell::UnsafeCell;
use core::convert::TryFrom;
use core::{ffi, fmt, mem};

#[repr(u32)]
#[non_exhaustive]
pub enum SocketEvent {
    Opened,
    Closed,
}

pub struct Socket {}

pub type SocketControlCallback = extern "C" fn(socket: *mut Socket, state: SocketEvent);
pub type SocketDataCallback = extern "C" fn(socket: *mut Socket, data: *const u8, len: usize);
pub type Handler = extern "C" fn();

pub const OPEN_SOCKET: u32 = Procedure::OpenSocket as u32;
pub const REGISTER_HANDLER: u32 = Procedure::RegisterHandler as u32;
pub const TRIGGER_EVENT: u32 = Procedure::TriggerEvent as u32;
pub const PRINT_STRING: u32 = Procedure::PrintString as u32;

#[repr(u32)]
enum Procedure {
    OpenSocket = 0x8BD6C7FF,
    RegisterHandler = 0xD35DBF5A,
    TriggerEvent = 0x65438A43,
    PrintString = 0x0A066986,
}

impl TryFrom<u32> for Procedure {
    type Error = ();

    fn try_from(id: u32) -> Result<Self, Self::Error> {
        match id {
            OPEN_SOCKET => Ok(Procedure::OpenSocket),
            REGISTER_HANDLER => Ok(Procedure::RegisterHandler),
            TRIGGER_EVENT => Ok(Procedure::TriggerEvent),
            PRINT_STRING => Ok(Procedure::PrintString),
            _ => Err(()),
        }
    }
}

enum Args {
    OpenSocket {
        remote_addr: [u8; 4],
        remote_port: u16,
        control_callback: SocketControlCallback,
        data_callback: SocketDataCallback,
    },
    RegisterHandler {
        event_id: u32,
        handler: Handler,
    },
    TriggerEvent {
        id: u32,
    },
    PrintString {
        str: *const ffi::c_char,
    },
}

#[macro_export]
macro_rules! invoke {
    () => {
        unsafe { core::arch::asm!("bl handle_call") }
    };
}
pub use invoke;

pub type EventIdent = u32;

struct HandlerStoreEntry {
    inner: UnsafeCell<Option<(EventIdent, Handler)>>,
}

impl HandlerStoreEntry {
    const fn new() -> Self {
        HandlerStoreEntry {
            inner: UnsafeCell::new(None),
        }
    }

    fn is_set(&self) -> bool {
        unsafe { *self.inner.get() }.is_some()
    }

    fn set(&self, id: EventIdent, handler: Handler) {
        unsafe { *self.inner.get() = Some((id, handler)) };
    }

    fn get(&self) -> Option<(EventIdent, Handler)> {
        unsafe { *self.inner.get() }
    }
}

impl fmt::Debug for HandlerStoreEntry {
    fn fmt(&self, f: &mut fmt::Formatter<'_>) -> fmt::Result {
        match unsafe { *self.inner.get() } {
            Some((id, handler)) => write!(f, "Handler: {id}, {handler:p}"),
            None => write!(f, "Handler: <free>"),
        }
    }
}

pub const HANDLERS_COUNT: usize = 32;

#[derive(Debug)]
struct HandlerStore {
    handlers: [HandlerStoreEntry; HANDLERS_COUNT],
}

impl HandlerStore {
    const fn new() -> Self {
        const DEFAULT: HandlerStoreEntry = HandlerStoreEntry::new();

        HandlerStore {
            handlers: [DEFAULT; HANDLERS_COUNT],
        }
    }

    fn next_free(&self) -> Option<&HandlerStoreEntry> {
        self.handlers.iter().find(|entry| !entry.is_set())
    }

    fn find_all(&self, id: EventIdent) -> impl Iterator<Item = Handler> + '_ {
        self.handlers
            .iter()
            .filter_map(|entry| entry.get())
            .filter_map(move |(eid, handler)| if eid == id { Some(handler) } else { None })
    }
}

unsafe impl Sync for HandlerStore {}

static STORE: HandlerStore = HandlerStore::new();

#[unsafe(no_mangle)]
pub extern "C" fn handle_call(id: u32, arg0: u32, arg1: u32, arg2: u32, arg3: u32) {
    let Some(args) = capture_call(id, arg0, arg1, arg2, arg3) else {
        log::warn!("ignoring API call ({id:#010x})");
        return;
    };

    match args {
        Args::OpenSocket {
            remote_addr,
            remote_port,
            control_callback,
            data_callback,
        } => {
            log::info!(
                "OpenSocket({remote_addr:?}, {remote_port}, {control_callback:p} {data_callback:p})"
            );
        }
        Args::RegisterHandler { event_id, handler } => match STORE.next_free() {
            Some(entry) => {
                log::debug!("RegisterHandler({event_id:#06x}, {handler:p}) @ {entry:p}");
                let _ = entry.set(event_id, handler);
            }
            None => {
                log::warn!("failed to register handler: no space")
            }
        },
        Args::TriggerEvent { id } => {
            log::info!("TriggerEvent({id})");
            STORE.find_all(id).for_each(|handler| {
                log::debug!("Calling: {handler:p}");
                handler()
            });
        }
        Args::PrintString { str } => match unsafe { ffi::CStr::from_ptr(str) }.to_str() {
            Ok(str) => log::info!("{str}"),
            Err(err) => log::warn!("PrintString failed: {err:?}"),
        },
    }
}

fn capture_call(id: u32, arg0: u32, arg1: u32, arg2: u32, arg3: u32) -> Option<Args> {
    match Procedure::try_from(id).ok()? {
        Procedure::OpenSocket => {
            let remote_addr = arg0.to_ne_bytes();
            let remote_port = arg1 as u16;
            let control_callback = unsafe { mem::transmute(arg2 as usize as *const ()) };
            let data_callback = unsafe { mem::transmute(arg3 as usize as *const ()) };

            Some(Args::OpenSocket {
                remote_addr,
                remote_port,
                control_callback,
                data_callback,
            })
        }
        Procedure::RegisterHandler => {
            let id: u32 = arg0;
            let func: u32 = arg1;

            Some(Args::RegisterHandler {
                event_id: id,
                handler: unsafe { core::mem::transmute(func) },
            })
        }
        Procedure::TriggerEvent => {
            let id: u32 = arg0;

            Some(Args::TriggerEvent { id })
        }
        Procedure::PrintString => {
            let str: u32 = arg0;

            Some(Args::PrintString {
                str: str as *const ffi::c_char,
            })
        }
    }
}
