crawford/PoE/software/supervisor/src/log/rtt.rs

// Copyright 2023 Alex Crawford
//
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
#![cfg(feature = "rtt")]

use crate::command::Interpreter;

use core::cell::UnsafeCell;
use core::mem::MaybeUninit;
use rtt_target::{DownChannel, UpChannel};

pub fn new(level: log::LevelFilter) -> Logger {
    Logger::new(level)
}

pub struct Logger {
    pub level: log::LevelFilter,
}

impl Logger {
    #[rustfmt::skip::macros(rtt_init)]
    fn new(level: log::LevelFilter) -> Logger {
        let channels = rtt_target::rtt_init! {
            up: {
                0: {
                    size: 1024
                    mode: NoBlockTrim
                    name: "terminal"
                }
                1: {
                    size: 4096
                    mode: NoBlockTrim
                    name: "logs"
                }
            }
            down: {
                0: {
                    size: 1024
                    mode: NoBlockTrim
                    name: "terminal"
                }
            }
        };

        rtt_target::set_print_channel(channels.up.1);
        unsafe {
            *TERMINAL.0.get() = MaybeUninit::new(Terminal {
                interpreter: Interpreter::new(),
                input: channels.down.0,
                output: channels.up.0,
            });
        }

        Logger { level }
    }
}

impl log::Log for Logger {
    fn enabled(&self, metadata: &log::Metadata) -> bool {
        metadata.level() <= self.level
    }

    fn log(&self, record: &log::Record) {
        if self.enabled(record.metadata()) {
            rtt_target::rprintln!(
                "{:<5} {}:{} - {}",
                record.level(),
                record.file().unwrap_or("UNKNOWN"),
                record.line().unwrap_or(0),
                record.args()
            )
        }
    }

    fn flush(&self) {}
}

#[repr(transparent)]
struct GlobalTerminal(UnsafeCell<MaybeUninit<Terminal>>);

unsafe impl Sync for GlobalTerminal {}

static TERMINAL: GlobalTerminal = GlobalTerminal(UnsafeCell::new(MaybeUninit::uninit()));

pub struct Terminal {
    interpreter: Interpreter,

    input: DownChannel,
    output: UpChannel,
}

impl Terminal {
    pub fn new() -> &'static mut Terminal {
        assert!(
            cortex_m::singleton!(: bool = false).is_some(),
            "terminal already initialized"
        );
        // TODO: check that logger has been initialized
        let terminal = unsafe { (&mut *TERMINAL.0.get()).assume_init_mut() };

        // Clear the buffer
        let mut input = [0u8; 1024];
        terminal.input.read(&mut input);

        // Draw the prompt
        terminal.interpreter.exec(&[], &mut terminal.output);

        terminal
    }

    pub fn poll(&mut self) {
        const INPUT_LEN: usize = 512;
        static mut INPUT: [u8; INPUT_LEN] = [0u8; INPUT_LEN];
        static mut LEN: usize = 0;

        let len = self.input.read(unsafe { &mut INPUT[LEN..] });
        if len == 0 {
            return;
        }
        unsafe { LEN += len; }

        let remaining = self
            .interpreter
            .exec(unsafe { &INPUT[..LEN] }, &mut self.output);
        unsafe {
            for (i, j) in ((LEN - remaining.len())..LEN).enumerate() {
                INPUT[i] = INPUT[j];
            }
            LEN = remaining.len();
        }
    }
}
