crawford/PoE/software/supervisor/src/log/mod.rs

// Copyright 2023 Alex Crawford
//
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
use core::cell::UnsafeCell;

pub mod itm;
pub mod rtt;

static LOGGER: Logger = Logger::new();

pub fn init() -> InitializedLogger {
    static mut INITIALIZED: bool = false;
    assert!(unsafe { !INITIALIZED }, "logger already initialized");
    unsafe { INITIALIZED = true };

    log::set_logger(&LOGGER).expect("set_logger");

    InitializedLogger {}
}

#[non_exhaustive]
pub struct InitializedLogger {}

impl InitializedLogger {
    #[cfg(feature = "itm")]
    pub fn add_itm(&self, logger: itm::Logger) -> &Self {
        log::set_max_level(log::max_level().max(logger.level));
        unsafe { *LOGGER.itm.get() = Some(logger) };

        log::info!("ITM logging online!");
        self
    }

    #[cfg(feature = "rtt")]
    pub fn add_rtt(&self, logger: rtt::Logger) -> &Self {
        log::set_max_level(log::max_level().max(logger.level));
        unsafe { *LOGGER.rtt.get() = Some(logger) };

        log::info!("RTT logging online!");
        self
    }
}

struct Logger {
    #[cfg(feature = "itm")]
    itm: UnsafeCell<Option<itm::Logger>>,

    #[cfg(feature = "rtt")]
    rtt: UnsafeCell<Option<rtt::Logger>>,
}

unsafe impl Sync for Logger {}

impl Logger {
    const fn new() -> Self {
        Logger {
            itm: UnsafeCell::new(None),
            rtt: UnsafeCell::new(None),
        }
    }
}

impl log::Log for Logger {
    fn enabled(&self, metadata: &log::Metadata) -> bool {
        #[cfg(feature = "itm")]
        match unsafe { &*self.itm.get() } {
            Some(itm) if itm.enabled(metadata) => return true,
            _ => {}
        }

        #[cfg(feature = "rtt")]
        match unsafe { &*self.rtt.get() } {
            Some(rtt) if rtt.enabled(metadata) => return true,
            _ => {}
        }

        false
    }

    fn log(&self, record: &log::Record) {
        #[cfg(feature = "itm")]
        if let Some(itm) = unsafe { &*self.itm.get() } {
            itm.log(record);
        }

        #[cfg(feature = "rtt")]
        if let Some(rtt) = unsafe { &*self.rtt.get() } {
            rtt.log(record);
        }
    }

    fn flush(&self) {
        #[cfg(feature = "itm")]
        if let Some(itm) = unsafe { &*self.itm.get() } {
            itm.flush();
        }

        #[cfg(feature = "rtt")]
        if let Some(rtt) = unsafe { &*self.rtt.get() } {
            rtt.flush();
        }
    }
}
