crawford/PoE/software/apps/api/build.rs

use std::env;
use std::fs::File;
use std::io::Write;
use std::path::PathBuf;

fn main() {
    let out = &PathBuf::from(env::var_os("OUT_DIR").unwrap());
    File::create(out.join("link.x"))
        .unwrap()
        .write_all(include_bytes!("link.x"))
        .unwrap();
    println!("cargo:rustc-link-search={}", out.display());

    println!("cargo:rerun-if-changed=build.rs");
    println!("cargo:rerun-if-changed=app.x");
}
