crawford/PoE/(commit log)

2018-03-02 firmware: initial commit
    This adds an initial LED demo for the EFM32GG11-SLSTK3701A development
    beard.
2018-03-02 firmware/main: fix fault handlers
    The panic handler was getting a linker error before. This will also
    light up the LEDs when Rust panics. This additionally adds a default
    exception handler, though this only works in release mode due to an
    upstream bug.
    [main.rs]
2018-03-02 firmware/main: remove led example
2018-03-02 firmware/ethernet: add initial phy driver
    This can enable the PHY so that it's able to establish a link between
    itself and another machine.
2018-05-10 firmware/ethernet: add initial network stack
    This seems to be able to receive frames into memory but the code is
    still full of warnings.
2018-05-10 firmware/ethernet: add basic miim support
    This adds support for reading and writing to the MII Management
    Interface (MIIM). This also enables ARM semihosting, allowing the
    firmware to print out debug info.
2018-05-31 firmware/*: update dependencies and build process
    This updates to cortex-m v0.5.1 which required a couple of build
    changes:
    - fat LTO disabled - Binaries ended up being larger with LTO enabled.
    - nix shell - An extra environment variable was needed now that
    cortex-m uses cc to build.
2018-07-04 cargo: bump efm32gg11b820 to v0.5.1
    v0.5.1 has a fix for the "device" crate feature inherited from
    cortex-m-rt.
2018-07-04 firmware/dma: ensure TxRegion is aligned properly
    RxRegion had the proper attribute, but it looks like TxRegion was
    forgotten.
2018-07-04 firmware/*: break EFM32GG into a MAC and PHY
    This defines a basic PHY interface so that alternate PHYs may eventually
    be used with the EFM32GG MAC. The KSZ8091 starts to implement this PHY
    interface. The EFM32GG MACPHY also no longer hardcodes the address of
    the PHY. It is dynamically discovered at runtime, further allowing
    alternate PHYs to be used in the future.
    [main.rs, mod.rs]
2018-07-04 firmware/phy: add IEEE defined registers
    This adds the registers from clause 22. Eventually, this will need to be
    updated to include clause 45. This should help reduce mistakes related
    to incorrect register addresses.
    [mod.rs]
2018-07-07 firmware/efm32gg: update TX implementation
    This new implementation more closely resembles the RX implementation. It
    breaks a frame into multiple buffers and uses the TX buffer queue as a
    ring buffer. This implementation is a little slower, but it should be
    much more robust.
2018-07-29 firmware/main: remove udp socket
    This is only going to use the TCP socket.
2019-01-06 firmware/*: convert to 2018 edition
    This doesn't immediately seem to have any benefit, but this should allow
    for more stability in the future and a potentially simpler syntax.
    [main.rs, mod.rs]
2019-01-28 firmware/main: pass timestamps to network stack
    Various network protocols need the timestamp in order to properly
    implement timeouts. This makes use of the RTC to pass millisecond-
    precision timestamps to the stack.
2019-05-22 firmware/*: use new led implementation
    This results in a little more code, but it is actually more correct.
    Each time the LEDs are created, the GPIOs are reconfigured. It's also
    much easier to read.
    [main.rs, mod.rs]
2019-09-16 hardware/*: add initial schematic
    [chassis.kicad_pcb, chassis.sch]
2019-09-16 hardware/*: remove netlist
    This file is no longer explicitly needed in KiCAD 5.
2019-09-16 hardware/*: various fixes based on review
    [chassis.kicad_pcb, chassis.sch]
2019-09-16 hardware/lib: use new RJ-45 jack
    [chassis.kicad_pcb, chassis.sch]
2019-09-16 hardware/*: finalize initial schematic and layout
    This marks the initial revision of the board.
    [chassis.kicad_pcb, chassis.sch]
2019-10-12 firmware/*: fix warnings about trait objects
    With newer versions of Rust, the following warning is displayed:
    warning: trait objects without an explicit `dyn` are deprecated
    [mod.rs]
2019-10-12 firmware/*: fix cortex-m deprecation warning
    cortex-m deprecated NVIC::enable in 0.6.1:
    warning: use of deprecated item 'cortex_m::peripheral::nvic::<impl
    cortex_m::peripheral::NVIC>::enable': Use `NVIC::unmask`
    [main.rs, mod.rs]
2019-12-08 firmware/main: log panic messages through ITM
    This will no longer light up both LEDs yellow, but instead send the panic message through the ITM.
    [main.rs]
2020-05-23 firmware/cargo: update and pin dependencies
    This replaces `version = "*"` with actual version numbers instead. This
    just makes it a bit easier to tell at a glance roughly what version of
    these crates this project is using. I also took the opportunity to use
    smoltcp v0.6.0 instead of a snapshot of the source.
2020-12-25 firmware/git: add itm trace to gitignore
    Support for ITM tracing was added back in 0ce2d5c5.
2020-12-25 firmware/efm32gg: fix reuse of transmit buffer
    The ethernet module only sets the ownership bit of the first descriptor
    in a frame; not all of the descriptors. I guess I hadn't noticed because
    I've only been transmitting small payloads.
    [mod.rs]
2021-06-01 chassis: various fixes
    [chassis.sch]
2021-07-12 main: move ethernet DMA regions before logging
    I'm not sure why, but logging stops functioning after these large
    buffers are allocated. Moving the allocations before the logging setup
    seems to fix the issue for now.
    [main.rs]
2021-07-12 efm32gg: rework lifetimes
    Consume ETH, RxBuffer, and TxBuffer.
    [main.rs, mod.rs]
2021-07-12 *: pin network buffers
    The DMA buffers and buffer descriptor lists need to be pinned in memory
    since the peripheral is also going to modify those structures.
2021-07-12 efm32gg: clean up the IRQ
    This uses the LED resources instead of stealing them.
2021-07-12 efm32gg: mask the mdio management done interrupt
    This fires early in the boot sequence, probably as a result of reading
    the OUI. Since it's not being used, just disable it for now.
2021-07-14 main: fix clock speed in ethernet delay
    The clock is 50 MHz, not 80 MHz.
    [main.rs]
2021-07-14 main: fix logging
    I believe the logging was stopping midway through because the logger
    itself had moved in memory. Doing the registration after the logger has
    been moved to its 'static location should ensure that logging reliably
    works. The Logger type had to be defined even without logging because
    RTIC asserts in main that the resources all implement Send:
    rtic::export::assert_send::<Logger>();
    [main.rs]
2021-07-21 tool: run openocd from within gdb
    This is so much easier than having to run openocd in the background.
    This also cleans up the OpenOCD config by making it a little more clear
    that off/false aren't related to uart, and removing the unneded trace
    frequency. The ITM output file is also being changed from a FIFO to a
    regular file. This is because OpenOCD hangs until the other end of the
    pipe is opened by itmdump, and it's a bit confusing when it happens
    within gdb.
2021-07-21 efm32gg: fix dma import path
    This only worked because of `use crate::efm32gg::dma;` in main.rs.
    [mod.rs]
2022-01-17 build: rework shell.nix
    - Pin the nixpkgs-mozilla repo
    - Use the mkShell function
    - Explicitly use sccache
    - Include LLVM tools (needed by `cargo size`)
2022-02-04 cargo: update dependencies, bump smoltcp to v0.8.0
    The latest revision of smoltcp now requires an implementation for a
    random number generator. This patch uses the MCU's TRNG to supply the
    underlying entropy. The network interface's socket set has also been
    absorbed, so there is no need to keep track of it externally.
    Updating crates.io index
    Updating git repository `https://github.com/crawford/efm32gg-hal`
    Updating aligned v0.3.4 -> v0.3.5
    Updating bitflags v1.2.1 -> v1.3.2
    Updating cortex-m v0.7.3 -> v0.7.4
    Updating cortex-m-rt v0.6.14 -> v0.6.15
    Updating cortex-m-rt-macros v0.1.8 -> v0.6.15
    Updating cortex-m-rtic v0.5.7 -> v0.5.9
    Updating embedded-hal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
2022-02-10 build: simplify OpenOCD config
    Turns out, there's a board definition that matches the current
    configuration. Additionally, add a reset at the end. It seems to help
    with the stability of the programmer.
2022-02-10 main: migrate to RTIC 1.0
    The main reason for migrating is the task cancel/reschedule
    functionality, which will allow network handling to be scheduled
    correctly. Without that mechanism, it wasn't possible for a network
    event to reschedule the handling before any existing scheduled
    handling. With the new structure of 1.0 though, the logging was
    allowed to be greatly simplified and now allows logging to happen from
    within the init function! This is because the logger has been moved
    into the mutable static (now a _real_ mutable static) which allows the
    logger to remain in the same location of memory for it's lifetime.
    I took the opportunity to restructure the socket handling
    slightly. The bulk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
    [main.rs]
2022-02-11 main: use a custom panic handler
    I wanted to add some timing information and a breakpoint when the
    debugger is attached.
2022-02-11 efm32gg: disable unhandled interrupt debugging
2022-02-11 efm32gg: use accurate source of delay for PHY power-up
2022-02-11 efm32gg: fix TX free-descriptor window length calculation
    If the window was only a single descriptor long, the length would be
    reported as 0.
    [mod.rs]
2022-02-11 efm32gg: fix TX buffer descriptor generation
    The length field in the buffer descriptor represents the length of the
    individual buffer; not the length of the frame. This needs to be set
    on all of the descriptors along with the last-buffer flag.
    [mod.rs]
2022-02-11 main: fix missed network events
    The default capacity for tasks is one, which meant that ETH interrupts
    were being ignored when there was already a scheduled spawn.
    Increasing the capacity to two is sufficient since handle_network only
    uses one slot for scheduling, leaving the remaining slot for eth_irq.
    [main.rs]
2022-02-14 *: add loopback socket and fio config
    This allows the rough performance to be measured using the following:
    fio nettest.ini
    Here is the current performance in release mode with the "silent"
    feature enabled:
    stress: (groupid=0, jobs=1): err= 0: pid=20485: Mon Feb 14 02:48:59 2022
    write: IOPS=693, BW=5547Kibit/s (5680kbit/s)(13.5MiB/20001msec); 0 zone resets
    clat (usec): min=1341, max=9476, avg=1437.41, stdev=99.01
    lat (usec): min=1341, max=9477, avg=1437.89, stdev=99.02
    clat percentiles (usec):
    | 1.00th=[ 1352], 5.00th=[ 1369], 10.00th=[ 1385], 20.00th=[ 1401],
    | 30.00th=[ 1401], 40.00th=[ 1418], 50.00th=[ 1434], 60.00th=[ 1450],
    | 70.00th=[ 1467], 80.00th=[ 1467]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
    [main.rs]
2022-02-14 *: use phy interrupts
    Instead of immediately spawning the network handler, wait until the
    link is up. This allows DHCP to complete more quickly because instead
    of incurring the 10-second back-off after transmitting into the void,
    the firmware waits until the PHY is ready to transmit.
    There is a one-second delay between the link-up interrupt and the
    network handler running. I'm not sure why this is needed, but I'll
    have to dig into it later.
2022-02-14 ksz8091: use core implementation to reverse bits
    [mod.rs]
2022-02-26 *: rework MAC initialization
    This breaks up the initialization into two steps: MDIO and MAC. This
    allows the MDIO to be used to configured the PHY (e.g. reading the
    OUI) before fully configuring the MAC. The MAC address is also now
    returned from the initialization so that it's not hard-coded twice.
    [main.rs, mod.rs]
2022-07-17 chassis: add library cache
2022-07-24 chassis: update to KiCad 6
    [chassis.kicad_pcb, chassis.kicad_sch, chassis.sch]
2022-07-24 chassis: reset 3D models
    KiCad 5 used KISYS3DMOD in the model paths, while KiCad 6 uses
    KICAD6_3DMODEL_DIR instead. The metadata also got updated, which is nice.
    [chassis.kicad_pcb]
2022-07-24 hardware: prepare for more KiCad projects
    [chassis.kicad_pcb, chassis.kicad_sch]
2022-07-24 chassis: correct a number of footprints
    These all mistakenly used an 0402 package:
    D1, C2, C3, C4, C6, C7, C8, C12, L1, L2, R2, R12
    [chassis.kicad_sch]
2022-07-24 chassis: fix value suffix and footprint for C28 and C30
    [chassis.kicad_sch]
2022-07-24 chassis: update footprint for D2 and hide value in schematic
    [chassis.kicad_sch]
2022-07-24 chassis: fix Ethernet jack footprint
    I misread the datasheet and thought the pins were arranged as follows:
    8 7 6 5
    4 3 2 1
    They should have been:
    8 6 4 2
    7 5 3 1
    [chassis.kicad_sch]
2022-07-24 common: fix footprint for alternate Ethernet jack
2022-09-06 flyback: add initial schematic
    This was copied from the existing (but non-functional) chassis schematic.
    [sync-flyback-eval.kicad_sch]
2022-09-06 flyback: fix wiring for jack
    The polarity of the data lines was mislabeled.
    [sync-flyback-eval.kicad_sch]
2022-09-06 flyback: clean up test points
    [sync-flyback-eval.kicad_sch]
2022-09-06 hardware: fix symbols for gate transistor
    The symbol for Si7898DP had the wrong polarity.
    [sync-flyback-eval.kicad_sch]
2022-09-06 flyback: various fixes
    [sync-flyback-eval.kicad_sch]
2022-09-06 flyback: use trimpots for tunable inputs
    DT (gate-to-gate dead time), FRS (switching frequency), and
    BLNK (blanking period).
    [sync-flyback-eval.kicad_sch]
2022-09-06 flyback: fix converter bypass capacitor value
    This is the capacitor between the high and low sides of the
    converter. It is specified as 2200 pF, which I misconverted to 2.2 uF
    instead of 2.2 nF.
    [sync-flyback-eval.kicad_sch]
2022-09-06 flyback: add protection diode to gate
    This was noted in the application note to have been added after the
    initial design. It's purpose is unclear.
    [sync-flyback-eval.kicad_sch]
2022-09-06 flyback: add missing diode network across secondary-side gate
    [sync-flyback-eval.kicad_sch]
2022-09-06 flyback: add missing RC pair to primary-side sync feedback
    [sync-flyback-eval.kicad_sch]
2022-09-06 flyback: build out secondary-side of synchronous feedback loop
    This more-closely follows the application note, adapted for a 12-volt output.
    [sync-flyback-eval.kicad_sch]
2022-09-06 flyback: specify range of trimpots
    [sync-flyback-eval.kicad_sch]
2022-09-06 flyback: use trimpots instead of trimmable resistors
    [sync-flyback-eval.kicad_sch]
2022-09-06 flyback: add minimum-voltage specifier to C11
    [sync-flyback-eval.kicad_sch]
2022-09-06 flyback: use internal slope compensation by default
    [sync-flyback-eval.kicad_sch]
2022-09-06 flyback: use trimpot to make output voltage adjustable
    [sync-flyback-eval.kicad_sch]
2022-09-06 flyback: dnp the two diode arrays
    Let's see what happens without them (I don't have them on-hand).
    [sync-flyback-eval.kicad_sch]
2022-09-06 flyback: add current-sense resistors to input and output
    [sync-flyback-eval.kicad_sch]
2022-09-06 common: add footprint and model for trimpot
2022-09-06 flyback: associate trimpot footprints
    [sync-flyback-eval.kicad_sch]
2022-09-06 flyback: address ERC results
    This came down to updating the library references (this was a result
    of the migration to KiCad 6), adding a power flag to VSS, and marking
    the Ethernet pins "no connection".
    [sync-flyback-eval.kicad_sch]
2022-09-06 flyback: enable PPD for a passive 24-volt adapter
    Following the calculations from SLVS885I 8.2.2.11 leads to a divider
    with values 6.04 kΩ and 62 kΩ, which gives an turn-on range of 14.3 V
    to 17.8 V. The detection resistor also needed to be updated to account
    for the additional parallel resistance.
    [sync-flyback-eval.kicad_sch]
2022-09-06 flyback: cleanup power flags and test points
    [sync-flyback-eval.kicad_sch]
2022-09-06 flyback: use through-hole cap for primary-to-secondary coupling
    This part is easier to use when bridging the air-gap between the
    primary and secondary sides.
    [sync-flyback-eval.kicad_sch]
2022-09-06 flyback: remove stray wire
    [sync-flyback-eval.kicad_sch]
2022-09-06 flyback: place the current-limiting resistor for the jack
    I didn't think I had this spec'd or sourced already.
    [sync-flyback-eval.kicad_sch]
2022-09-06 flyback: improve testpoints
    This changes a number of footprints to be through-hole instead of a
    pad. The current sense resistor on the output was also moved to the
    outside of the secondary-side output coupling capacitor; plus, an
    extra testpoint was added to the other side.
    [sync-flyback-eval.kicad_sch]
2022-09-06 common: add model for PowerPAK SO-8
    Model by Felix Georgievich ILgach on 3D Content Central.
2022-09-06 flyback: customize a few footprints
    These new ones have 3D models.
    [sync-flyback-eval.kicad_sch]
2022-09-06 flyback: shuffle a few connections to make layout easier
    [sync-flyback-eval.kicad_sch]
2022-09-06 flyback: add second earth-coupling capacitor to simplify pcb layout
    [sync-flyback-eval.kicad_sch]
2022-09-06 flyback: fix footprints for R3, R6, and D3
    [sync-flyback-eval.kicad_sch]
2022-09-06 flyback: fix value of C6 and add voltage designators to C6-C9
    [sync-flyback-eval.kicad_sch]
2022-09-06 flyback: label VSS and VDD
    This just makes it a bit easier to identify during board layout.
    [sync-flyback-eval.kicad_sch]
2022-09-06 flyback: add initial board layout
    I think I'm happy with this as-is for the first revision. For the
    future though, I think it might be cleaner to move T2 and C16 to the
    other side of T1. There were also a number of design rule exclusions
    related to the clearance around VSSA and VDDA. I was shooting for a
    spacing of 0.025" as advised by the reference manual, but a few of the
    footprints were too small to accommodate.
    [sync-flyback-eval.kicad_pcb]
2022-09-06 flyback: add sheet details
    [sync-flyback-eval.kicad_pcb]
2022-09-06 flyback: shift C9 to provide a bit more clearance
    [sync-flyback-eval.kicad_pcb]
2022-09-08 common: fix the footprint for the PoE flyback transformer
    The pads were mirrored across the X axis.
2022-09-08 common: fix the footprint for the pulse transformer
    The pads were mirrored along the X axis.
2022-09-16 flyback: update layout with new footprints
    This ended up shuffling quite a bit around. I got rid of the notch in
    the board, since that space is now needed. A lot of this will be
    simplified once the varistors are no longer needed.
    [sync-flyback-eval.kicad_pcb, sync-flyback-eval.kicad_sch]
2022-09-21 Expand absolute path search to Windows
    Previously this commit hook was only checking for the presence of paths on
    MacOS and other Unix flavored systems. This expands the check to search
    for the presence of a Windows "C:\" (though the slash is reversed to conform
    to the syntax of Kicad).
2022-10-21 common: add symbol and footprint for SWD debug header
2022-10-21 common: add footprint and model for vertical Ethernet jack
2022-10-21 common: add footprint and model for two-pin terminal block
2022-11-28 git: fix check for unannotated parts
    This was erroneously matching single-line declarations like the
    following:
    (reference "R4") (unit 1) (value "?") (footprint "")
2022-11-28 passthru: add initial project and design
    This is partially copied and pasted from the sync-flyback design, with
    the addition of the Ethernet PHY and MCU from the chassis
    design. Additionally, there is a 3.3-volt buck converter that has been
    added to supply power to the logic.
    [passthru.kicad_sch]
2022-11-28 passthru: route the load-sense signal
    The load-sense signal is routed through PC4 into the positive terminal
    of opamp 0. From there, it can optionally pass through a second opamp
    to further amplify the signal before being read by ADC0.
    [passthru.kicad_sch]
2022-12-07 passthru: add decoupling cap for internal LDO
    The reference manual also suggests that VREG_VDD should be connected
    to VDD, even though the bypass switch and DC-DC converter are
    disabled. Since that pin is adjacent to DVDD, I'm going to do it
    without looking into why it's recommended.
    [passthru.kicad_sch]
2022-12-07 common: remove redundant negation in reset pin label for EFM32
    [passthru.kicad_sch]
2022-12-07 passthru: add decoupling cap to load sense signal
    Unsure if this is needed, but it should help dampen any ringing
    present in the signal.
    [passthru.kicad_sch]
2022-12-08 passthru: assign the rest of the footprints
    Just going with 0603s for everything except the shut resistor, which I
    already have stocked.
    [passthru.kicad_sch]
2022-12-08 passthru: update a few manufacturing constraints
    These were pulled over from the sync-flyback evaluation board.
2022-12-11 passthru: add driver circuit for load switch
    [passthru.kicad_sch]
2022-12-11 passthru: assign the rest of the footprints
    [passthru.kicad_sch]
2022-12-11 passthru: fix test point values
    [passthru.kicad_sch]
2022-12-13 passthru: update FETs to Si7465
    [passthru.kicad_sch]
2022-12-13 passthru: flip magnetics to make routing easier
    [passthru.kicad_sch]
2022-12-13 passthru: ground the load switch through the PoE bypass FET
    This will prevent the load from being enabled until the PoE
    negotiation has completed. It also makes routing a little easier.
    [passthru.kicad_sch]
2022-12-13 common: add footprint for shielded RJ45 jack
    Splurging for the shielded connector. It'll give a little extra
    strength in case the cable gets yanked.
2022-12-13 passthru: use shielded RJ45 jack
    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
    [passthru.kicad_sch]
2022-12-14 passthru: add current-limit between MAC and PHY
    [passthru.kicad_sch]
2022-12-14 passthru: add 50 MHz crystal
    Not sure how I forgot this...
    [passthru.kicad_sch]
2022-12-14 passthru: connect Ethernet interrupt
    I know enough of the layout to know that this will work well connected
    anywhere between PE8 and PE13.
    [passthru.kicad_sch]
2022-12-14 passthru: add initial PCB layout
    First pass at a layout. The signal pairs probably need to be tuned for
    length. Spacing on the 58-V rail might need to be adjusted. A few of
    the models are missing - it'd be nice to have those.
    [passthru.kicad_pcb]
2022-12-14 passthru: route the PHY reset
    [passthru.kicad_pcb, passthru.kicad_sch]
2022-12-14 passthru: route the signals for the LEDs
    [passthru.kicad_pcb, passthru.kicad_sch]
2022-12-14 passthru: simplify silkscreen and add DRC exceptions
    [passthru.kicad_pcb]
2022-12-14 passthru: mark the classification resistor
    This will just make it easier to find on the board.
    [passthru.kicad_pcb]
2022-12-14 passthru: various cleanup
    [passthru.kicad_pcb]
2022-12-15 passthru: use local footprint for PFETs
    This one has 3D models.
    [passthru.kicad_pcb, passthru.kicad_sch]
2022-12-15 passthru: update 3D models
    [passthru.kicad_pcb]
2022-12-15 passthru: update oscillator
    This one has a 3D model.
    [passthru.kicad_pcb, passthru.kicad_sch]
2022-12-15 passthru: clean up a few silkscreen DRC violations
    [passthru.kicad_pcb]
2022-12-15 passthru: adjust shape of earth plane
    [passthru.kicad_pcb]
2022-12-15 passthru: add pre-release revision to board
    [passthru.kicad_pcb]
2022-12-15 passthru: finalize production parameters
    I also spaced out the VDD rail a bit further.
    [passthru.kicad_pcb]
2022-12-16 passthru: change package for C28
    This is a larger-capacity capacitor.
    [passthru.kicad_pcb, passthru.kicad_sch]
2022-12-16 passthru: increase the resistance of the VDD shunt resistor
    Assuming a maximum VDD current of 600 mA, this will give a maximum
    sense voltage of 0.6 V and 36 mW of power draw.
    [passthru.kicad_pcb, passthru.kicad_sch]
2022-12-16 passthru: update resistor values
    The 6.1 kΩ resistor was hard to find. I also added the
    current-limiting resistors for the LEDs.
    [passthru.kicad_pcb, passthru.kicad_sch]
2022-12-16 passthru: update footprint for C24
    This needs to be larger because of the higher voltage.
    [passthru.kicad_pcb, passthru.kicad_sch]
2022-12-16 passthru: rebalance RX/TX pairs
    [passthru.kicad_pcb]
2022-12-16 passthru: add metadata to schematic and layout
    [passthru.kicad_pcb, passthru.kicad_sch]
2022-12-16 passthru: move development to revision B
    [passthru.kicad_pcb]
2022-12-29 build: pin Rust to 1.66.0
2023-04-21 efm32gg: remove LED configuration
    This was always a bit of a hack to help with debugging. Neither the
    MAC nor PHY should know anything about the LEDs. I tried making this
    more generic with hooks, but it ended up a little unbalanced - the
    LEDs were passed into the interrupt handler, but were stolen by the
    hooks. In the long term, it might make more sense to move all of this
    functionality to RX/TX start/stop hooks.
2023-04-21 efm32gg: remove PHY-enable signal
    Not all boards will be able to shut off power to the PHY like the
    development board can (presumably for testing power consumption).
2023-04-21 efm32gg: make pins generic
    This seems to be the best way of allowing different combinations of
    pins for the different boards.
2023-04-21 efm32gg: reconfigure RMII
    The passthru PCB has a 25 MHz crystal on HFXO, so HFCLK is 25 MHz and
    CLKOUT2 needs to be doubled. The refclk is on PA3, MDIO on PB3, and
    MDC on PB4.
2023-04-21 cargo: update to led v0.3.1
2023-04-26 passthru: add initial firmware
    This implements DHCP and works with Rev. A with the following reworks:
    - Pins 7 and 8 swapped on the 8P8C jack
    - Crystal oscillator replaced with a 25 MHz crystal
    [passthru.rs]
2023-04-26 passthru: add support for identity LED
    Sending a "1" to port 51900 will make the identity LED
    blink. Likewise, sending a "0" will stop it.
2023-04-26 passthru: refactor ID LED into something a little higher-level
2023-05-25 *: use network LED to show state
    This has made it quite a bit easier to troubleshoot. The network LED
    remains solid on when the network is uninitialized (this would only be
    seen if the firmware panicked early on) and solid off when the network
    is fully configured (currently, successful DHCP). The rest of the
    time, the network LED uses an occulting flash pattern to indicate the
    state:
    1. No link
    2. No DHCP
    The priority level of the two flashing tasks was increased to avoid a
    deadlock (and theoretically improve the UX). The following panic was
    seen when a DHCP lease was obtained:
    panicked at 'spawning occult_network_led: ()', src/bin/passthru.rs:153:41
    [passthru.rs, slstk3701a.rs]
2023-05-25 *: add support for RTT
    This setup allows multiple loggers (ITM and RTT currently) to operate
    in parallel. Eventually, I'd like to introduce dynamically-enabled
    loggers and the ability to change the logging level at runtime.
    The OpenOCD configuration assumes that the RTT control block will be
    within the first 4 KiB of memory, which is not a great
    assumption. Ideally, the linker script would place the control block
    into a known location in memory, but that's going to require
    modification to both cortex-m and rtt-target.
2023-05-25 passthru: cleanup error handlers
    And re-enable the LEDs in the panic handler. I forget why I removed that.
    [passthru.rs]
2023-05-25 passthru: reset DHCP configuration when link is acquired
    This helps cut down significantly on the start-up time. It's not the
    most efficient, but it does have the nice property of allowing the
    operator to easily move the device between DHCP domains (e.g. VLANs).
    [passthru.rs]
2023-05-25 passthru: cleanup silkscreen
    Removed the part designators from the one side of the board, since they
    really aren't necessary, and removed the redundant "+" from the
    caution label.
    [passthru.kicad_pcb]
2023-05-25 passthru: replace network error led with general one
    Rename the "Network" LED to "Error". Now that the firmware supports
    occulting codes, this will be used for general error reporting. I also
    included a preliminary error code chart. I hope this doesn't prove to
    be too limiting.
    [passthru.kicad_pcb]
2023-05-25 passthru: add polarity markings
    [passthru.kicad_pcb]
2024-05-12 log: cleanup and address potential UB
    This was spawned by the following error message, introduced in 1.77.0:
    warning: creating a shared reference to mutable static is discouraged
    --> src/log/mod.rs:36:27
    |
    36 | let logger = unsafe { &LOGGER };
    | ^^^^^^^ shared reference to mutable static
    |
    = note: for more information, see issue #114447 <https://github.com/rust-lang/rust/issues/114447>
    This changes the implementation slightly so that it no longer returns
    a reference to the logger itself; instead returning a marker type that
    is called in the same way as the original. It also removes the use of
    `cortex_m::singleton!`, si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
    [mod.rs]
2025-07-22 Revert RMII reconfiguration
    This reverts commit 53232dc33c72ce9254cc9bb4cde30802092f9c8c, since
    I'm moving back to the dev kit for now. This really should be moved to
    the board-specific code.
    [mod.rs]
2025-07-22 Enable error LED for slstk3701a
    It'd be great if this was factored out. Probably not worth the trouble
    right now.
    [slstk3701a.rs]
2025-07-22 Add telnet socket
    With the feature enabled, the command interpreter is exposed to the
    network as a telnet socket. This is actually a really pleasant way to
    troubleshoot issues without having to re-flash firmware and reset.
    [passthru.rs, slstk3701a.rs]
2025-07-22 Fix premature socket closure
    I don't fully understand what is happening here. This is old code that
    I haven't investigated in a while. All I know is that without this
    commented out, connections to the socket are immediately closed.
2025-07-22 Fix warnings when telnet is disabled
    [slstk3701a.rs]
2025-07-22 Allocate more sockets
    No particular reason. I just know that I'll need more and I'm tired of
    hitting panics. This also brings the number of routes in line.
2025-07-22 Convert passthru schematic to KiCad 7
    [passthru.kicad_sch]
2025-07-22 Adjust the debugger config
    Here's a few of the notes I took along the way.
    This does not work (could not find MEM-AP):
    reset_config srst_only combined srst_nogate srst_open_drain connect_assert_srst
    This does not work (could not find MEM-AP):
    reset_config srst_only srst_nogate srst_open_drain connect_assert_srst
    This works (currently stops in the hardfault handler):
    reset_config srst_only srst_open_drain connect_assert_srst
    Warn : 'srst_nogate' reset_config option is required
2025-07-22 Add subcommand for printing start of program space
    This is needed in order to actually link binaries destined for that
    address space.
2025-07-22 Fix the logger so that it doesn't use UB
    [mod.rs]
2025-07-30 Fix trace output in hard-fault handler
2025-08-11 Implement PrintString
2025-08-11 Print the RegisterHandler event_id in hex
2025-08-11 Increase size of buffer for telnet socket
    This probably needs a better solution.
2025-08-11 Fix TriggerEvent to support reentrancy
    This intercepts calls to TriggerEvent and does the stack manipulation
    to return to the event handler. This involves modification of LR, so
    the caller of SVC needs to save it -- it's equivalent to a branch.
    [passthru.rs, slstk3701a.rs]
2025-08-11 Fix help text alignment
    Terminus on iOS needed the carriage returns.
2025-08-15 Update OpenOCD config for ITM
    Here were the logs from OpenOCD 0.12.0:
    ```
    command.c:155 script_debug(): command
    - tpiu config internal log.itm uart false 9500000
    arm_tpiu_swo.c:1053 handle_tpiu_deprecated_config_command():
    DEPRECATED 'tpiu config' command: Adding a TPIU
    'efm32.cpu.tpiu' in the configuration
    arm_tpiu_swo.c:1062 handle_tpiu_deprecated_config_command():
    DEPRECATED 'tpiu config' command: Target efm32.cpu uses AP
    autodetection. Adding TPIU on AP 0; can be revised later
    arm_tpiu_swo.c:1068 handle_tpiu_deprecated_config_command():
    DEPRECATED 'tpiu config' command: Running:
    'tpiu create efm32.cpu.tpiu -dap efm32.dap -ap-num 0x0'
    command.c:155 script_debug():
    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
2025-08-15 Add RTT to OpenOCD config
    This makes it easier to use gdb directly, since RTT gets set up and
    the sockets are opened on start-up. Just nc to 9091 to get logs.
2025-09-23 Reset telnet socket when remote end is closed
    This allows the socket to be re-used by the next connection. This
    doesn't quite feel correct, but it seems to be the way intended by
    0d836a63. The other way that worked (but felt worse) was to check if
    the socket was in the TcpState::CloseWait state.
2025-10-02 Configure Emacs to target eval board by default
2025-10-02 Fix the comment-start used by Emacs for assembly
    `;;` doesn't actually comment the line, apparently.
2025-11-13 Pin the nixpkgs version
    Okay, it's not exactly pinned; but it's much more stable.
2026-10-20 Update and pin nix-shell dependencies
