crawford/PoE/(notices)

Notices in the files:
firmware/src/main.rs:
This program is free software: you can redistribute it and/or modify
it under the terms of the GNU General Public License as published by
the Free Software Foundation, either version 3 of the License, or
any later version.
parts and their libraries:
Copyright 2016 Accelerated Designs. All rights reserved.
